ekiwi/iph/measurements/20140710/20MHz_random_data/Readme.md

# 20MHz of random data

## Scope0-6
* Signal Generator Output: 2V
* Modulated Current Source with 47 Ohm resistor to ground and 470 Ohm series
  resistance
* green: input signal
* red: optical output, received with custom board
