ekiwi/iph/presentation/pres01.odp

Optischer Link

## Analoger Link

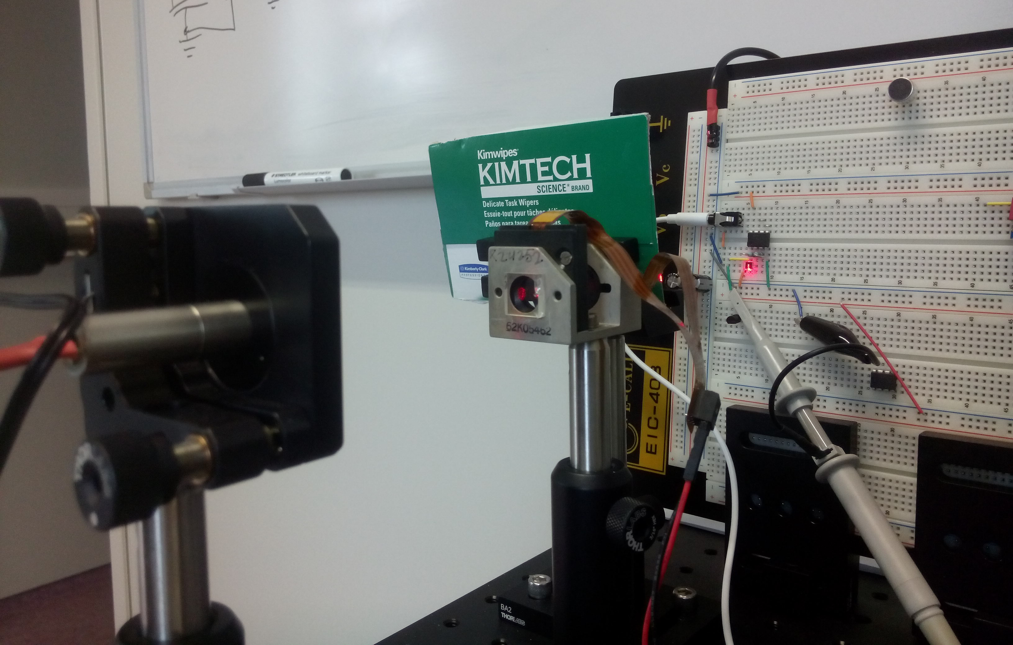
[picture p18: figure]

Ziel:

externe Modulation eines Lasers

mittels LCD-Pixel

## Slide 3

Laser

Signalgenerator

Sinus 0-1000Hz

LCD Pixel

Photodiode

mit Bias

Oszilloskop

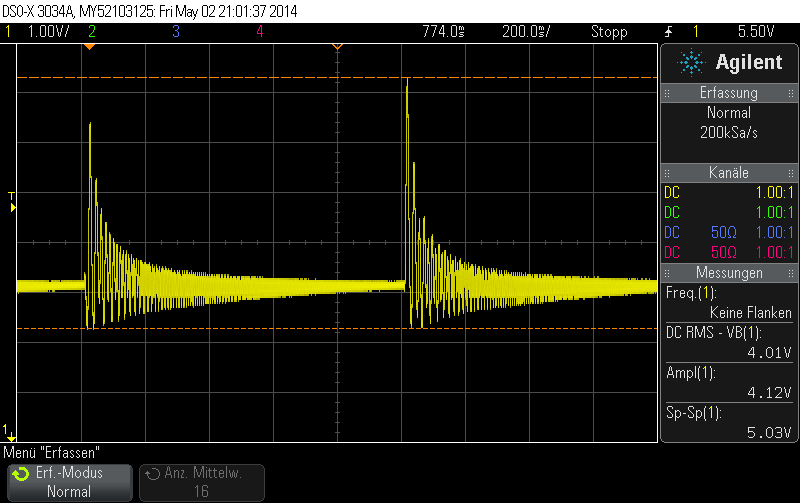
[picture p19: figure]

## Slide 4

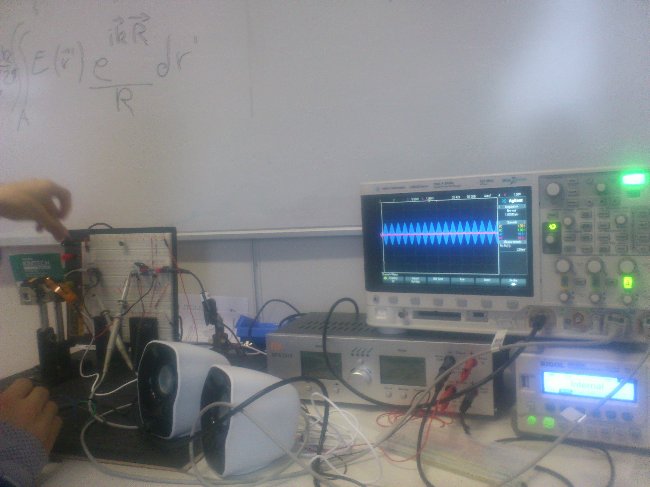
[picture p20: figure]

## Slide 5

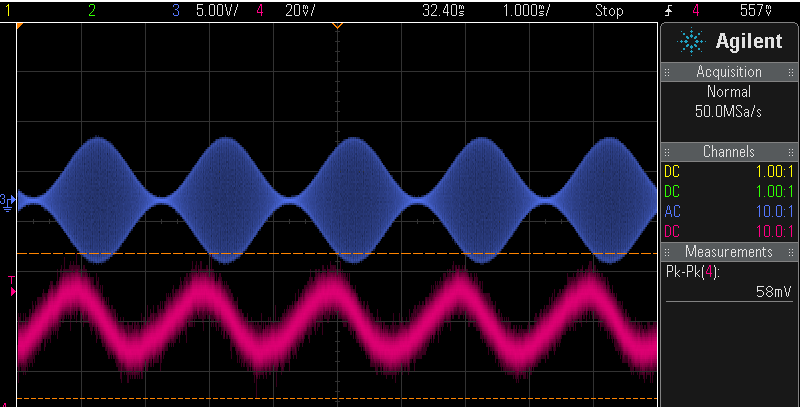
[picture p21: figure]

## Slide 6

Raphael

## UART

## Slide 8

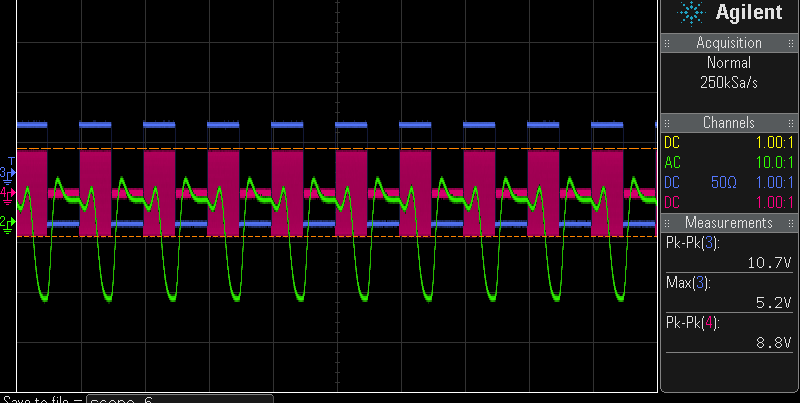
[picture p22: figure]
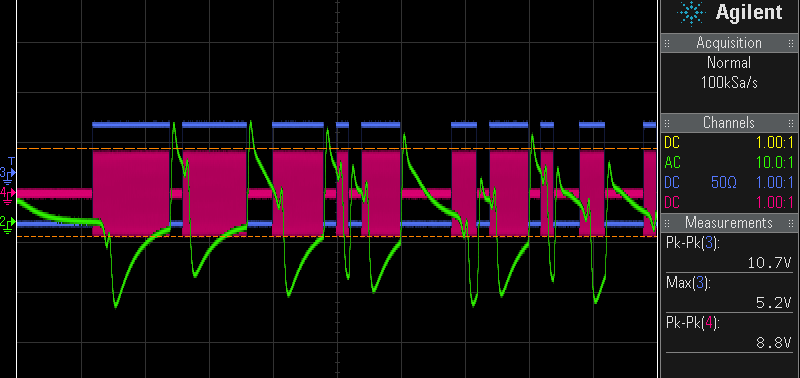
[picture p23: figure]

10 Hz

toggle

10 Hz

zufällig

## 4 Hz Software UART

Kevin

## Digitaler Link

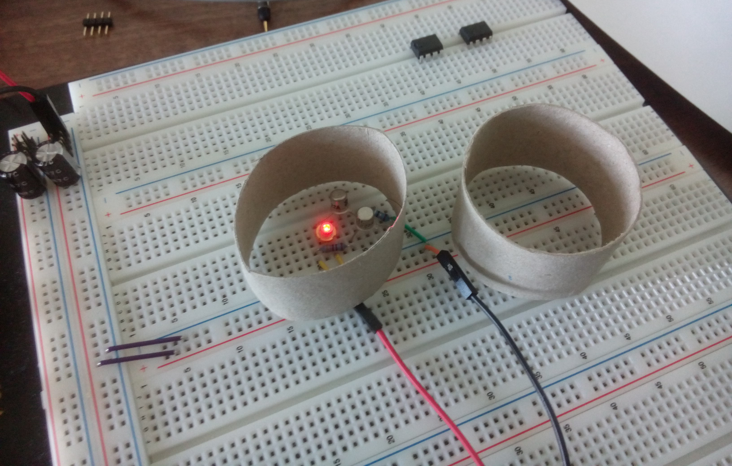
[picture p24: figure]

Ziel:

Direkte Modulation einer Laserdiode

## Direkt modulierbare Stromquelle

- Kevin

## Augendiagramme und weiter Bilder

- Raphael
