ekiwi/iph/report.pdf

Institut fur integrierte Photonik ¨

der

RWTH Aachen University

Institutsprojekt

# Optischer Link

### Teilnehmer: Raphael Brandis Kevin Laufer ¨

### Betreuer: Johannes Hauck

### 31. August 2014

## Inhaltsverzeichnis

1 Aufgabenstellung | 2
2 Extern modulierter Laser | 2
2.1.1 | Ubertragungscharakteristik | ¨ | 3
2.2 Ubertragung von Audiosignalen | ¨ | | 4
2.3 Ubertragung digitaler Daten | ¨ | | 6
2.3.2 | Datenubertragung mit 10 Hz | ¨ | 7
3 Direkt modulierter Laser | 12

3.3 Empfänger mit integriertem AD8015 Transimpedanzverstärker 16

4 Fazit | 20
A C++-Quellcode-Ausschnitte | 21

1

## 1 Aufgabenstellung

Wir sind Studenten der Elektrotechnik an der RWTH Aachen und haben unser Viertsemester-Institutsprojekt am Institut fur Integrierte Photonik (IPH) ¨ absolviert. Im Rahmen dieses Projekts haben wir uns mit der Ubertragung ¨
von Informationen uber optische Links besch ¨ | äftigt.
Im ersten von zwei Projektteilen ging es zunächst um Informationsuber- ¨ mittlung mittels eines extern modulierten Laserstrahls. Anschließend sollte im zweiten Abschnitt des Projekts eine Laserdiode direkt moduliert und auf diese Weise digitale Daten ubertragen werden. ¨

## 2 Extern modulierter Laser

Um mit einem mit konstanter Intensität strahlenden Laser Informationen zu ubertragen, muss mindestens ein Parameter des Laserstrahls extern modu- ¨ liert werden. Mögliche Modulationsparameter sind beispielsweise die Amplitude oder die Phase des Laserstrahls. In unseren Versuchen kam ausschließlich Amplitudenmodulation zum Einsatz.
Wenn die Amplitude eines Laserstrahls extern moduliert werden soll, sind wiederum verschiedene Aufbauten als Modulator denkbar. Ein Lautsprecher mit einem in der Mitte der Membran angebrachten kleinen Spiegel kann je nach Auslenkung der Membran die Intensität des auf der Photodiode des Empfängers auftreffenden Lichts verändern; mit dieser Technik hat sich eine zweite Projektgruppe genauer beschäftigt. Wir haben uns stattdessen fur die ¨ Variante entschieden, bei der ein einzelner LCD-Pixel¹
| zum Einsatz kommt.

### 2.1 LCD-Modul als Modulator

Ein einzelner Pixel eines LCD besteht ublicherweise aus einer Fl ¨ | ussigkristall- ¨
schicht, an die uber zwei Elektroden ein elektrisches Feld angelegt werden ¨ kann, sowie einem horizontalen und einem vertikalen Polarisationsfilter, je einer vor und einer hinter der Kristallschicht.
Wären die Flussigkristalle nicht vorhanden, w ¨ | urden beide Polarisations- ¨
filter zusammen das gesamte einfallende Licht herausfiltern. Die zusätzliche Kristallschicht zwischen beiden Filtern sorgt jedoch fur eine Drehung der ¨ Polarisation des durch den ersten Filter polarisierten Lichts. Da sich die
Ausrichtung der Kristalle uber das angelegte Feld beziehungsweise ¨ | uber die ¨
angelegte Spannung steuern lässt, lässt sich somit auch die Menge des insgesamt durchgelassenen Lichts steuern.

1
engl. liquid crystal display

2

Da in unseren Versuchsaufbauten eine Laserdiode als Lichtquelle diente, war das in den Modulator einfallende Licht bereits polarisiert. Der von uns verwendete LCD-Pixel musste daher nur uber einen Polarisationsfilter hinter ¨ der Kristallschicht verfugen. ¨

### 2.1.1 Ubertragungscharakteristik ¨

Um das Ubertragungsverhalten des verwendeten LCD-Modulators zu ermit- ¨ teln, haben wir zunächst einen sehr einfachen Versuchsaufbau verwendet: Der Modulator wurde direkt an einen Rigol DG1022 -Signalgenerator angeschlossen, als Empfänger diente eine kommerziell erhältliche Photodiode mit integrierter Biasspannung. Mit dem Oszilloskop konnten wir nun die Amplitude des empfangenen Signals bei Ubertragung von Sinusschwingungen ¨

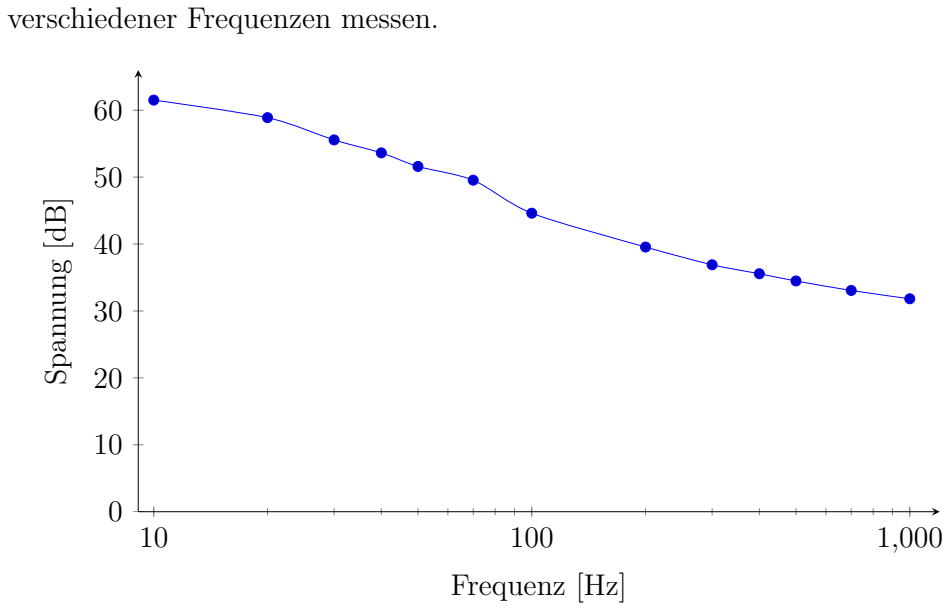
[picture p25: figure]
verschiedener Frequenzen messen.; Frequenz [Hz]; Spannung [dB]

Abbildung 1: Ubertragungscharakteristik des LCD-Modulators (Tr ¨ | ägerfre-
quenz: 100 kHz, Amplitude: ±6 V)

In unseren Messungen fiel die Amplitude schon im niedrigen zweistelligen Frequenzbereich stark ab. Bei einer von 10 Hz ausgehenden Messreihe war der −3 dB-Punkt bereits bei cirka 20 Hz erreicht. Durch Verwendung einer hochfrequenten Trägerwelle, die mit dem niederfrequenten Nutzsignal amplitudenmoduliert wurde²

, ließ sich das Ubertragungsverhalten geringf ¨ | ugig ¨
verbessern (siehe Abbildung 2). Insgesamt mussten wir dennoch feststellen,

2 Diese Funktion stellte der verwendete Signalgenerator von Haus aus bereit.

3

dass sich der von uns verwendete LCD-Pixel aufgrund seiner geringen Geschwindigkeit nur eingeschränkt als Modulator zur Informationsubertragung ¨ eignet (siehe Frequenzgang in Abbildung 1).

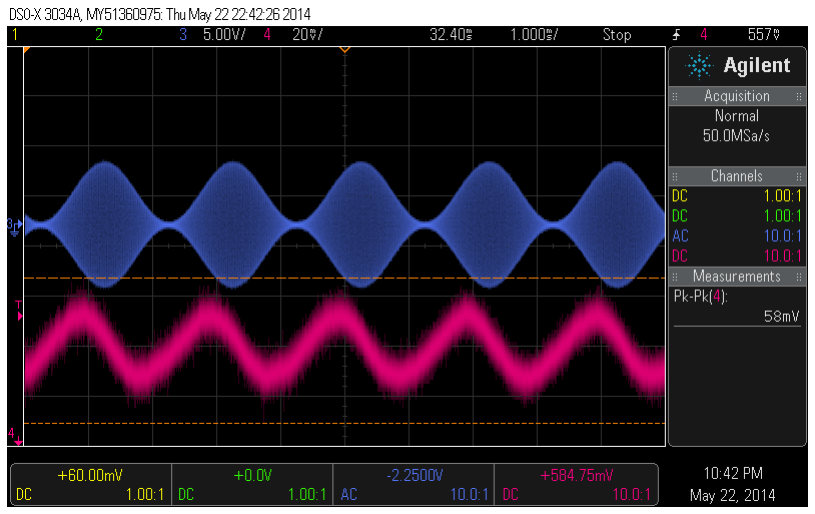
[picture p26: figure]

Abbildung 2: Blau: AM-modulierte Trägerwelle, Rosa: Empfangenes Signal

### 2.2 Ubertragung von Audiosignalen ¨

Im nächsten Schritt sollten statt einfachen Sinussignalen, die sich direkt im Signalgenerator erzeugen lassen, komplexere Audiosignale mithilfe unseres analogen Links ubertragen werden — beispielsweise Musik. ¨
Aufgrund der in Abschnitt 2.1.1 erläuterten Versuchsergebnisse war es unser Ziel, den Modulator weiterhin mit einer hochfrequenten, amplitudenmodulierten Trägerwelle anzusteuern. Da der Modulationseingang des Signalgenerators nach einem Pegel von ±5 V verlangte, haben wir zunächst auf dem Breadboard eine diskrete Kopfhörerverstärkerschaltung aufgebaut, die das aus einem Smartphone oder einem Computer kommende Musiksignal auf den nötigen Pegel verstärkt.
Auf der Empfängerseite kam eine ebenfalls diskret aufgebaute Transimpedanzverstärkerschaltung zum Einsatz, an die zwei aktive Lautsprecher angeschlossen wurden. Der Aufbau aus Laserdiode, LCD-Modulator und Photodiode mit Transimpedanzverstärker ist in Abbildung 3 zu sehen.

4


Abbildung 3: Versuchsaufbau zur Ubertragung von Audiosignalen ¨

War bei der Ubertragung einzelner Sinust ¨ | öne der Ton noch bis in hohe Fre-
quenzbereiche (>10 kHz) hörbar, so verschlechterte sich das Ubertragungs- ¨ verhalten fur breitbandige Musiksignale sehr stark. Erst durch eine Band- ¨ breitenbegrenzung der Musik auf Frequenzen bis maximal 750 Hz wurden einzelne Basstöne aus dem Ursprungssignal erkennbar, die jedoch weiterhin von starken Störgeräuschen und Verzerrungen begleitet wurden.

5

(a) Bandbreitenbegrenztes Ursprungssignal
(b) Mit einem Mikrofon aufgezeichnete Ausgabe der Lautsprecher

Abbildung 4: Ubertragung eines Musiksignals ¨

In Abbildung 4 ist die geringe Ubereinstimmung der Wellenformen des zu ¨
ubertragenden Musiksignals (4a) und des aus den Lautsprechern zu h ¨ | örenden
Signals (4b) zu erkennen.
Auch bei reinen Sprachsignalen reichte die Ubertragungsqualit ¨ | ät bei wei-
tem nicht aus, um Sprachverständlichkeit zu gewährleisten.

### 2.3 Ubertragung digitaler Daten ¨

Nach den Experimenten mit der analogen Signalubertragung war es von In- ¨ teresse, auch einmal digitale Daten uber den bestehenden optischen Link zu ¨ ubertragen. ¨

### 2.3.1 USB-UART-Dongle

In einem ersten Ansatz wurden gunstige UART ¨

3
| -USB-Adapter verwendet.
Die Adapter arbeiten mit 3.3 V-CMOS-Signalen, die mittels eines Komparators auf den nötigen Pegel von ±5 V gebracht werden. Mit diesem Pegel lässt sich der Eingang des Rigol DG1022 -Signalgenerators ansteuern. Bei Amplitudenmodulation fuhren dann +5 V zur maximalen Amplitude und -5 V ¨ zu einer Amplitude von fast Null. So ließ sich ein einfaches On-Off-Keying umsetzen.

3 Universal Asynchronous Receiver / Transmitter

6

Leider war es nicht möglich, bei den verwendeten UART-Adaptern Baudraten unter 1 kHz einzustellen. Dies war aber deutlich zu schnell fur das LCD, ¨ wie man in Abbildung 5 sehen kann. Hier wurde am Computer eine Taste im Terminal gedruckt gehalten, um immer den gleichen Wert zu senden. ¨
Man beachte, dass bei dieser und allen folgenden Messungen der grune ¨ Kanal, also die Messung am Ausgang des Transimpedanzverstärkers, auf AC Coupling eingestellt war. Somit sind die Messergebnisse nicht verlässlich und es lassen sich höchstens Tendenzen feststellen. Hier wäre es interessant, die Messungen noch einmal mit richtigen Einstellungen zu wiederholen. Dennoch ist klar erkennbar, dass ein kurzes High am Ausgang des UART-Adapters (blauer Kanal) zu wenig Anderung am Ausgang des Transimpe- ¨ danzverstärkers fuhrt. Das LCD kann dem Signal vermutlich nicht schnell ¨ genug folgen.

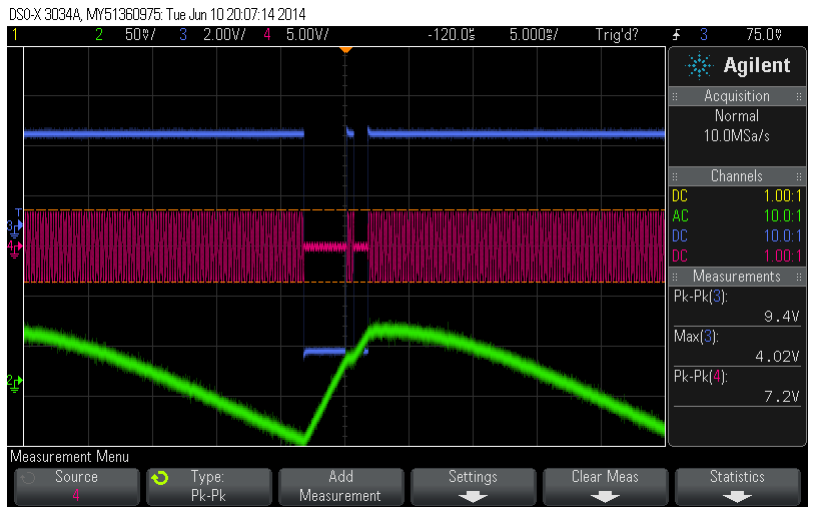
[picture p27: figure]

Abbildung 5: Hier wird kontinuierlich der gleiche Wert mittels UART gesendet.

### 2.3.2 Datenubertragung mit 10 Hz ¨

Nachdem die UART-Adapter nicht langsam genug Daten liefern konnten, wurde als nächstes ein weiterer Signalgenerator verwendet, der in der Lage war, Bitsequenzen mit einer bestimmten Frequenz zu erzeugen, in unserem Fall mit 10 Hz. Diese Bitsequenzen wurden genutzt, um mittels On-Off-Keying das LCD anzusteuern.
Interessant ist hierbei der Unterschied zwischen einem determinierten Muster aus sich abwechselnden Nullen und Einsen und einem Zufallsmuster. Wie in Abbildung 6 gut zu sehen ist, kann sich das LCD auf eine konstante

7

Frequenz einschwingen. Bei einem Zufallssignal hingegen hängt das Signal von der Vorgeschichte ab. Hier wird deutlich, warum bei Messungen der Signalqualität (z.B. bei der Erstellung von Augendiagrammen, siehe 3.4) ein Zufallssignal verwendet werden sollte und ein deterministisches Signal nicht ausreicht.

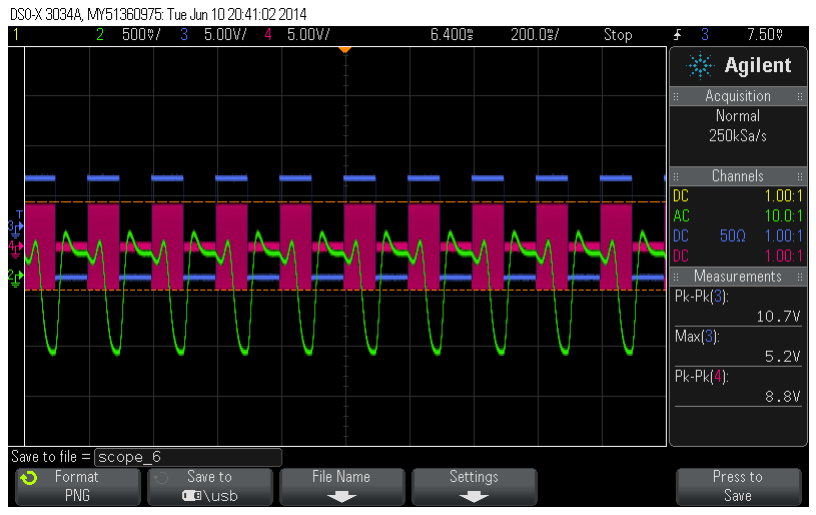
[picture p28: figure]

(a) Abwechselnde Nullen und Einsen

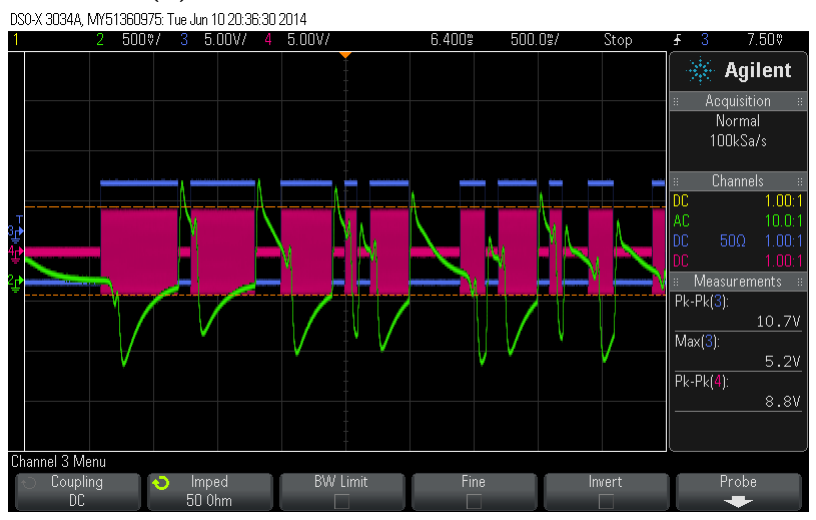
[picture p29: figure]

(b) Zufälliges Signal

Abbildung 6: Ubertragung verschiedener 10 Hz-Signale ¨

### 2.3.3 Software-UART mit Mikrocontrollern

Um nun endlich digitale Nutzdaten zu ubertragen, haben wir auf einem ¨ Mikrocontroller UART in Software implementiert, um die verwendete Baudrate beliebig niedrig wählen zu können. Hierzu wurden zwei STMicroelectronics Discovery Boards verwendet, eines mit STM32F4 - und eines mit

8

STM32F3 -Mikrocontroller. Der Quellcode nutzt die XPCC -Bibliothek und ist auf http://github.com/ekiwi/iph abrufbar. Die wichtigsten funktionalen Bestandteile sind aber auch im Anhang A zu finden.
Zur Verbesserung der Robustheit der Ubertragung kam ein (7,4)-Hamming- ¨
Code zum Einsatz, bei dem alle gultigen Codew ¨ | örter untereinander einen
Hammingabstand von mindestens drei besitzen. Somit kommen auf vier Datenbits drei Paritätsbits, was die Korrektur einfacher Bitfehler erlaubt. Ein möglicher Algorithmus hierfur sieht wie folgt aus (siehe auch Quellcode in ¨ Anhang A.1):
Fur ein empfangenes Wort wird der Hammingabstand zu jedem g ¨ | ultigen ¨
Codewort errechnet. Beträgt der Abstand eins oder null, wird davon ausgegangen, dass das empfangene Wort dem Codewort entspricht. Bei zweifachen Bitfehlern fuhrt dies zu einer falschen Zuordnung: Da der Hammingabstand ¨
zwischen zwei gultigen Codeworten drei betr ¨ | ägt und bei zwei Bitfehlern der
Abstand zum ursprunglichen Codewort zwei ist, gibt es ein anderes Code- ¨ wort, zu dem die empfangene Sequenz nur einen Hammingabstand von eins hat. Diesem Codewort wird das empfangene Wort fälschlicherweise zugeord-

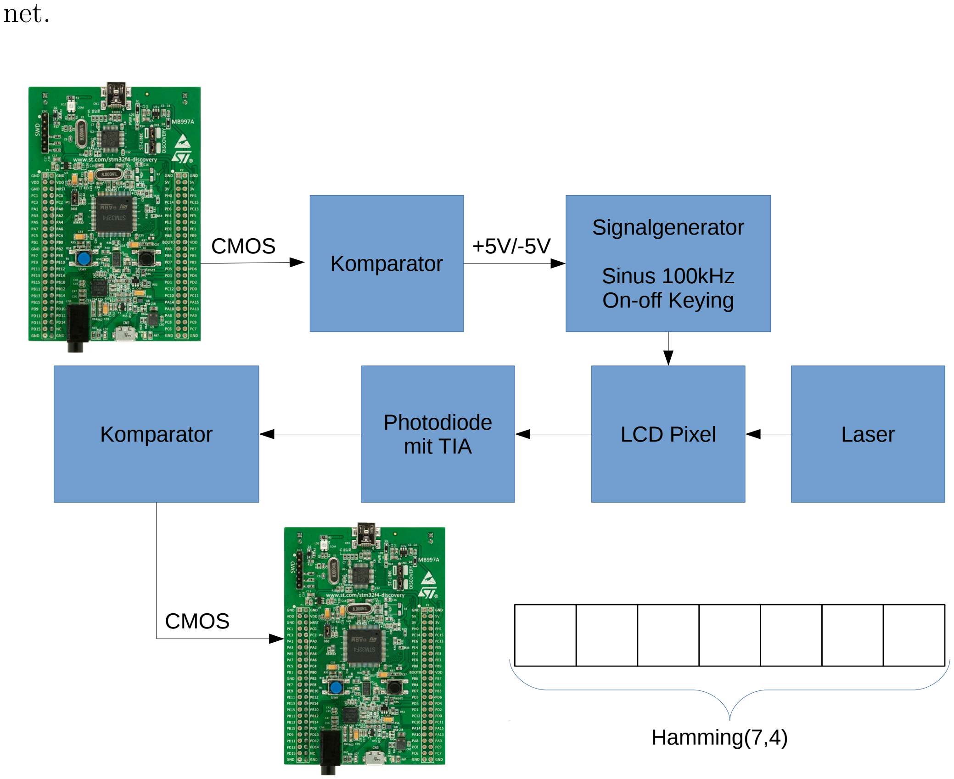
[picture p30: figure]
net.; Signalgenerator; Sinus 100kHz On-off Keying; Komparator; LCD Pixel; Laser; CMOS; Photodiode mit TIA; Hamming(7,4)

Abbildung 7: Software-UART-Signalkette

9

Zum Test der Ubertragung wurden 294 Datenw ¨ | örter in (7,4)-Hamming-
Codierung ubertragen. Der Versuchsaufbau ist in Abbildung 7 dargestellt. ¨ Die Positionierung des Lasers und der Empfängerdiode entsprachen dem in Abbildung 3 gezeigten Aufbau. Der Inhalt der Datenpakete waren die Zahlen von 0 bis 15. Dies reduziert die Aussagekraft des Experiments etwas im Vergleich zu randomisierten Daten, erleichterte aber die Auswertung erheblich. Um nämlich zwei oder mehr Bitfehler erkennen zu können, mussen die ¨ gesendeten Daten am Empfänger bekannt sein. Somit gelangten wir zu der in Abbildung 8 dargestellten Fehlerverteilung.
| 0 Fehler

26%

1 Fehler

62%

2+ Fehler

12%

Abbildung 8: Fehler bei der Ubertragung von 294 (7,4)-Hamming- ¨ codierten, deterministischen Datenworten mit einem 4 Hz-UART-Signal

Demnach sind, nach Fehlerkorrektur durch den Hammingcode, immer noch
12 % der empfangenen Daten falsch und mussten in einem echten ¨ | Ubertra- ¨
gungssystem durch höhere Layer abgefangen werden. Die Rate der Datenbits berechnet sich wie folgt:

4 bit/s ∗

4 bit
7 bit
≈ 2.3 bit/s | (1)
Somit wurden uber etwa 30 cm mit 2 ¨ | .3 bit/s und einer recht hohen Fehler-
rate von 12 % Daten ubertragen — kein sehr gutes Ergebnis. ¨
Doch wie ist dieses schlechte Resultat zu erklären? Fur eine Erkl ¨ | ärungsver-
such lohnt es sich, die Messungen in Abbildung 9 zu betrachten. Hier sieht man, dass eine zufällig ausgewählte steigende Flanke (9a) 162 ms benötigt, um durch das System zu propagieren. Eine fallende Flanke (9b) hat mit 20 ms eine deutlich kleinere Verzögerung. Weitere beobachtete Flanken wiesen Verzögerungen in der gleichen Größenordnung auf.

10


(a) steigende Flanke: 162 ms


(b) fallende Flanke: 20 ms

Abbildung 9: Verzögerung bei einem 4 Hz-UART-Signal; Quellensignal in gelb und invertiertes Ausgangssignal in grun¨

Da bei einem zufälligen Bit eine steigende Flanke sowohl an dessen Anfang als auch an dessen Ende auftreten kann, musste man demnach mehr als ¨ 162 ms nach Anfang und 162 ms vor Ende eines Bits sampeln, um Fehler ganz zu vermeiden. Dies fuhrt zu folgender maximaler Datenrate: ¨

Tmin = 162 ms ∗ 2 = 324 ms | (2)

fmax =

1

Tmin

=

1
324 ms
≈ 3 bit/s | (3)

Ein Absenken der Bitrate auf 3 bit/s in Kombination mit einer intelligenten Wahl des Samplingzeitpunktes könnte also eine Hamming-Codierung uber- ¨
flussig machen und somit zu einer h ¨ | öheren Datenrate fuhren. Hierf ¨ | ur m ¨ | ussen ¨
aber die Latenzen bekannt sein und bei der Synchronisation durch die erste fallende Flanke (siehe Anhang A.3, Zeile 39) berucksichtigt werden. ¨

11

Als wir bei einem Test ohne Kenntnis der Latenz mit einer Datenrate von 2 bit/s Daten ubertragen haben, traten fast keine Bitfehler auf. ¨
Die mit den oben aufgefuhrten Berechnungen ermittelte maximale theoreti- ¨ sche Datenrate von etwa 3 bit/s ist jedoch weiterhin sehr niedrig. Interessant wäre es daher, die Ursache der Latenz zu untersuchen. Hierbei sollte bei verschiedenen Ansteuerungsarten des LCD die erzielte Latenz gemessen werden. Mit den oben genannten Berechnungen lässt sich daraus die mögliche Datenrate berechnen.

## 3 Direkt modulierter Laser

Im zweiten Teil des Projekts sollte ein Diodenlaser direkt moduliert werden, um damit digitale Daten zu ubertragen. Dazu hatte die andere Gruppe ¨ bereits eine Modulationsmethode untersucht, bei der auf einen konstanten Strom ein Datensignal aufgekoppelt wurde.
Unser Ziel war es, eine Stromquelle direkt mit einem Datensignal zu modulieren und danach Empfängerdesigns zu evaluieren.

### 3.1 Sender: Modulierte Konstantstromquelle

Aufgrund der exponentiellen Kennlinie einer Laserdiode muss diese mit einem konstanten Strom versorgt werden. Eine einfache Konstantstromquelle lässt sich mit zwei Bipolartransistoren aufbauen, wie in Abbildung 10 zu sehen ist.

12

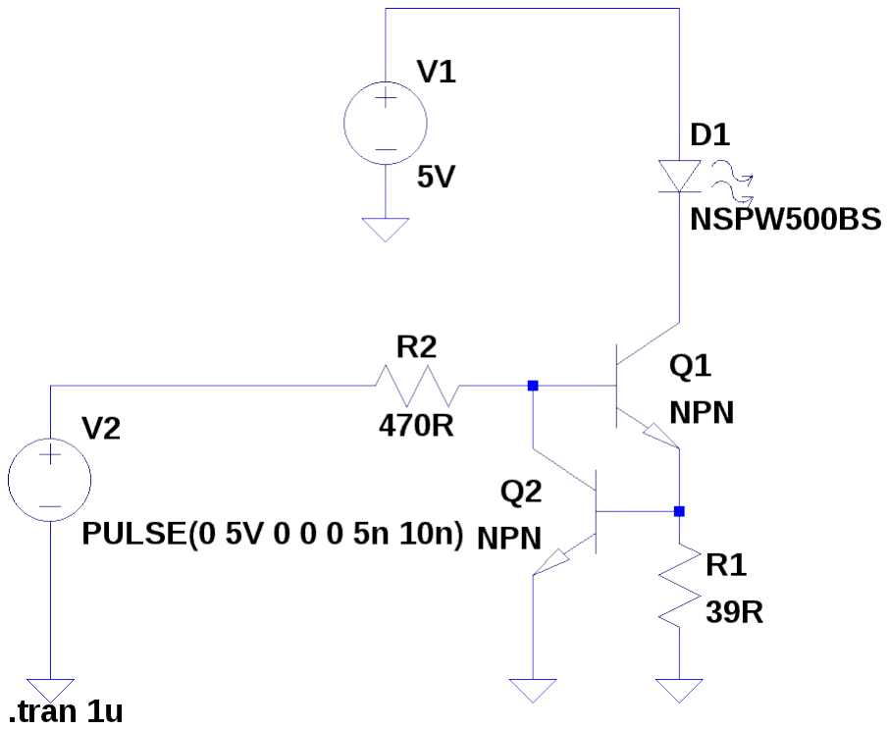
[picture p31: figure]

Abbildung 10: Modulierte Stromquelle.

Der Strom ID1, der durch die Diode fließt, entspricht hierbei in etwa dem Strom IR1, der durch den Widerstand R1 fließt. An diesem mussen, durch ¨ den Transistor Q2 vorgegeben, etwa 0.7 V abfallen, wodurch sich folgender Strom einstellt:

ID1 = IR1 =

UR1
R1

≈

0.7 V
R1

(4)

Diese Konstantstromquelle lässt sich leicht ein- und ausschalten, indem uber einen Widerstand die Summe der Basis-Emitter-Spannungen beider ¨ Transistoren, UBE1 + UBE2, vorgegeben wird.

13

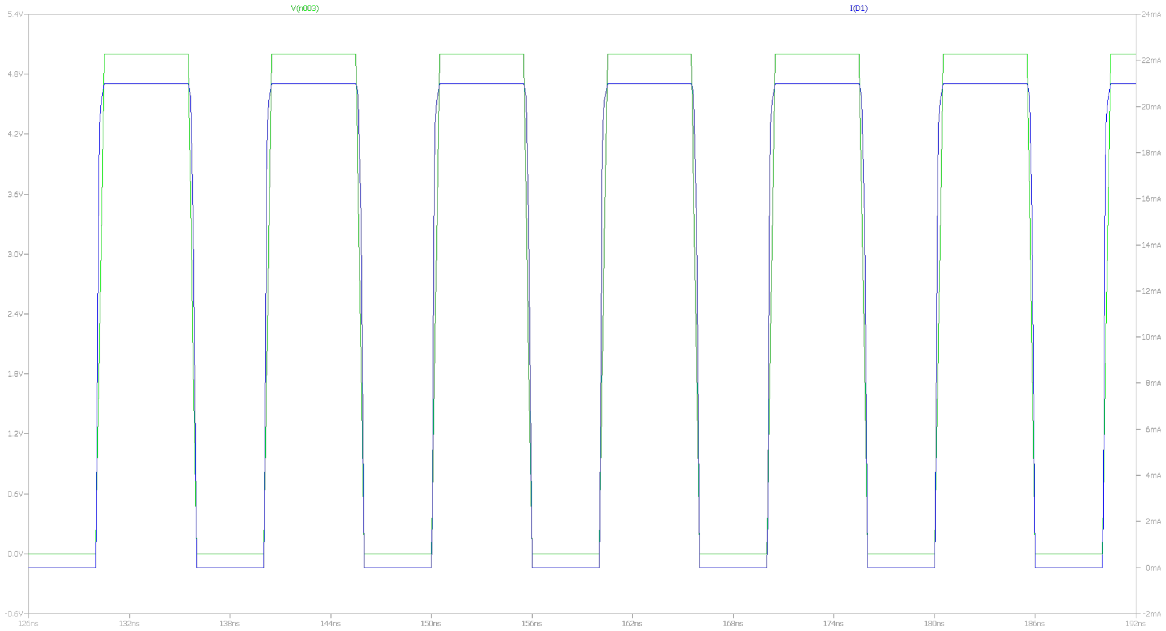
[picture p32: figure]

Abbildung 11: Transientenanalyse der modulierten Stromquelle

Eine Simulation des Aufbaus in LTSpice zeigt, dass der Strom ID1 durch die Diode von der Eingangsspannung U2 abhängt. Bei den in Abbildung 11 dargestellten Ergebnissen wurde zwar mit einem vereinfachten Transistormodell simuliert, sie sind also mit Vorsicht zu genießen. Das Funktionsprinzip wird durch die Simulation dennoch gut veranschaulicht.

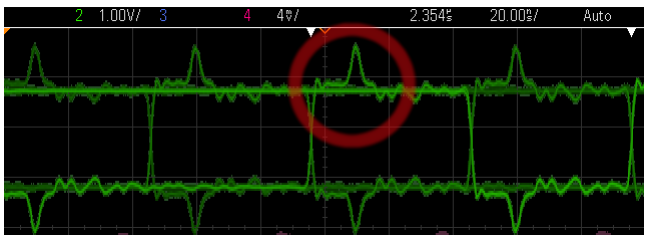
[picture p33: figure]

Abbildung 12: Reflexionen bei einem 20 MHz-Eingangssignal

Mit diesem Aufbau ließen sich in unseren Versuchen recht schnelle Ubert- ¨ ragungen von zufälligen Bits realisieren (siehe auch Abschnitt 3.2). Es gab jedoch aufgrund der fehlenden Terminierung auf der Eingangsseite unserer Schaltung Probleme mit Reflexionen auf der Leitung (siehe Abbildung 12).

14

Hier wäre eine Untersuchung verschiedener Terminierungsvarianten interessant.
Auch verhält sich die Schaltung bei Frequenzen im Megahertzbereich immer weniger wie in der Simulation: So entspricht die Spannung am Widerstand R1 nicht mehr den erwarteten 0.7 V. Hier wären eine Verbesserung der Spice-Simulation durch die Auswahl eines passenden Transistormodells und durch bessere Modellierung der Quelle sowie weitere empirische Versuche angebracht.

### 3.2 Photodiode mit Lastwiderstand als Empfänger

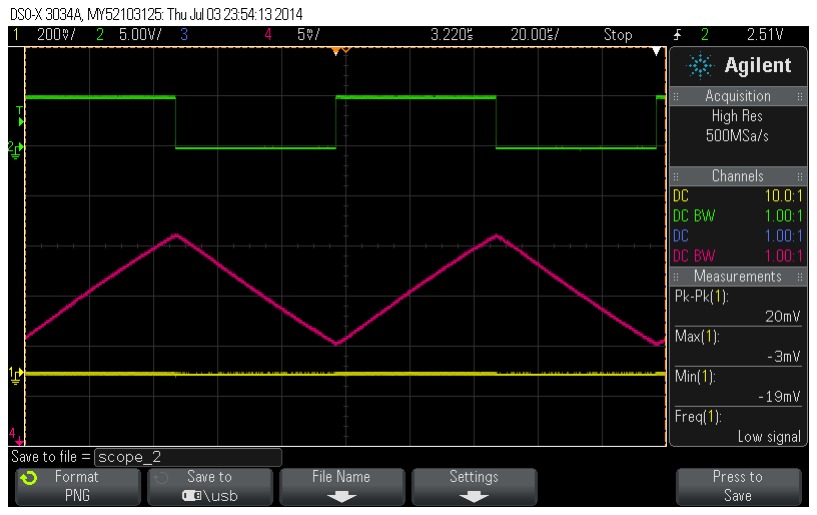
[picture p34: figure]

(a) 10 kΩ


(b) 50 Ω

Abbildung 13: Grun: Gesendetes 20 kHz-Rechtecksignal; Rosa: Empfange- ¨ nes Signal bei unterschiedlichem Lastwiderstand

Zum Testen der Sendeschaltung nutzten wir zunächst eine Photodiode mit Biasspannung und umschaltbarem Lastwiderstand (NewFocus 1623 ) als Empfänger.

15

In Abbildung 13 ist die Abhängigkeit des Ausgangssignals vom Lastwiderstand zu erkennen. Zur Aufnahme dieser Messungen wurde der Ausgang der Photodiode mit einem hochohmig terminierten Eingang eines Oszilloskops verbunden und auf den Eingang unserer Sendeschaltung ein 20 kHz-Rechtecksignal gegeben. Bei einem hohen Lastwiderstand (13a) erhöht sich die Verstärkung: Die Amplitude beträgt hier in etwa 10 mV. Jedoch sinkt die Bandbreite, was sich durch sehr lange Anstiegs- und Abfallzeiten und die daraus resultierende Dreiecksform des Ausgangssignals bemerkbar macht. Mit einem kleineren Lastwiderstand (13b) ergibt sich ein weniger verzerrtes Signal, die Amplitude beträgt jedoch nur noch in etwa 1 mV.
Die kleinen Amplituden und die Verzerrung beim Empfang eines 20 kHz-
Signals weisen darauf hin, dass fur schnellere Signale ein besserer Verst ¨ | ärker
benötigt wird.

### 3.3 Empfänger mit integriertem AD8015 Transimpedanzverstärker

C2

10u

C3

100n

GND

+5V

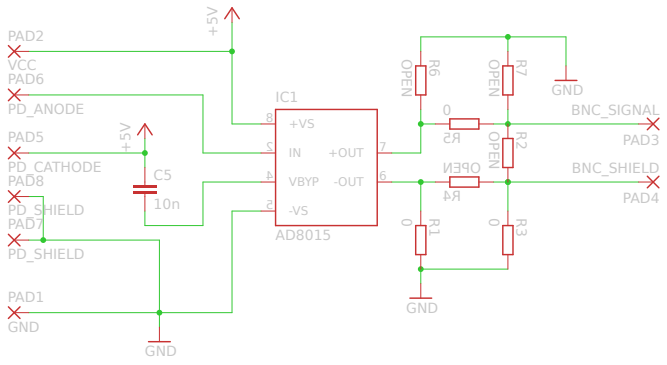
[picture p35: figure]
GND; +OUT; -OUT; VBYP 4; PAD1; PAD2; VCC; PAD3; BNC_SIGNAL; PAD4; BNC_SHIELD; PAD5; PD_CATHODE; PAD6; PD_ANODE; PAD7; PD_SHIELD; PAD8; OPEN

Abbildung 14: Beschaltung des AD8015 -Transimpedanzverstärkers

Anstatt selbst eine Empfängerschaltung aufzubauen, bietet es sich an, einen integrierten Transimpedanzverstärker wie den AD8015 zu verwenden. Dieser ist von Grund auf dafur konzipiert, den Photostrom in eine proportional ¨ verstärkte Spannung zu wandeln, die differentiell mit einer Impedanz von

16

50 Ω am Ausgang abgegriffen werden kann. Es werden nur wenige externe Komponenten benötigt, was zu einer einfachen Schaltung fuhrt (siehe Abbil- ¨ dung 14).
Mit diesem Aufbau lassen sich auch schnelle Signale verstärken, wie in der Betrachtung der Augendiagramme im nächsten Abschnitt deutlich wird.

### 3.4 Augendiagramme

Augendiagramme können mit dem Oszilloskop aufgenommen werden. Hierzu wird der Trigger auf steigende und fallende Flanken des Signals eingestellt und Persistenz aktiviert. Hierdurch erhält man eine Uberlagerung von stei- ¨ genden und fallenden Flanken. Verbleibt zwischen diesen eine klar erkennbare Offnung (das Auge), kann man davon ausgehen, dass die Bits auch von einer ¨ Empfängerschaltung richtig interpretiert werden können.
Wichtig ist, als Eingangssignal eine Zufallssequenz von Bits zu wählen, damit sich das System nicht einfach auf eine Frequenz einschwingt.


Abbildung 15: Versuchsaufbau zur Erstellung der Augendiagramme

17

In unserem Fall wurden die Augendiagramme in Abbildung 16 und Abbildung 17 mit der Sendeschaltung aus Abschnitt 3.1 und der Empfängerschaltung aus Abschnitt 3.3 aufgenommen. Der Aufbau ist in Abbildung 15 zu sehen.

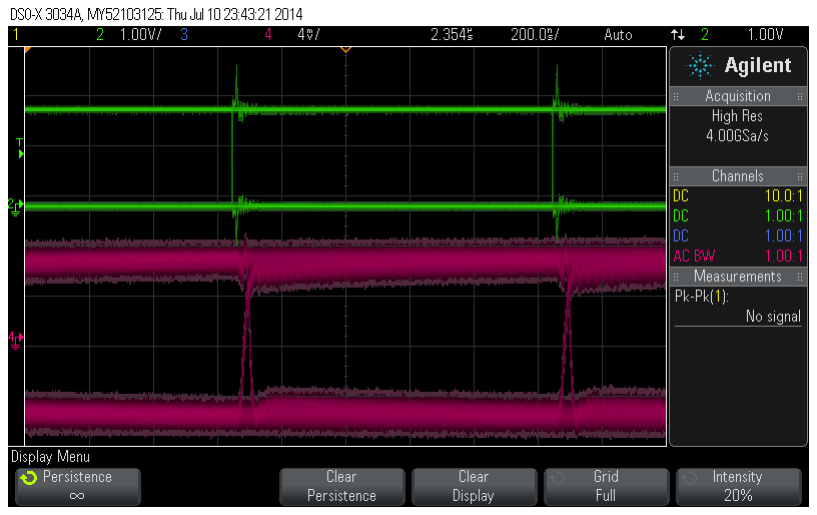
[picture p36: figure]

(a) 1 MHz


(b) 10 MHz

Abbildung 16: Augendiagramme (gesendetes Signal in grun) ¨

18


(a) 30 MHz


(b) 50 MHz

Abbildung 17: Augendiagramme (gesendetes Signal in grun) ¨

Ein 1 MHz-Bitsignal wird ohne Probleme ubertragen (16a), auch bei ei- ¨ nem 10 MHz-Signal ist die Augenöffnung noch unproblematisch (16b). Ein
30 MHz-Signal hat bereits eine deutlich kleinere Offnung (17a), die ¨ | Ubertra- ¨
gung sollte hier aber auch noch funktionieren. Bei 50 MHz scheint die Grenze erreicht; hier ist eine distinkte Offnung kaum noch zu erkennen (17b). ¨

### 3.5 Ergebnisse

Mit dem System aus selbst gebauter modulierbarer Stromquelle und AD8015 -Verstärker lassen sich Signale mit einer Geschwindigkeit von bis zu 50 MHz
gut ubertragen. Die Photodiode ohne Verst ¨ | ärker ist hingegen in diesem Ge-
schwindigkeitsbereich nicht mehr zu gebrauchen.
Bezuglich des Senders sollte man als n ¨ | ächstes versuchen, die verwendete
Schaltung wie in Abschnitt 3.1 beschrieben zu verbessern, um sie dann auf einer Platine aufzubauen. Zusammen mit einem Gehäuse ließe sich damit ein

19

Versuchsaufbau erstellen, mit dem die Schaltung noch besser untersucht und der Laser auch in eine Glasfaser eingekoppelt werden könnte.
Der Empfänger mit AD8015 hat sich bewährt und muss wohl erst einmal nicht verändert werden. Es wäre aber interessant, ihn noch besser zu vermessen. Unter anderem sollte mit einer professionellen Lichtquelle untersucht werden, bis zu welchen Frequenzen verstärkt werden kann. Bisher wurde hier nur das Gesamtsystem aus Empfänger und Sender untersucht, was es erschwert, eindeutige Aussagen uber die Einzelkomponente zu tref- ¨ fen. Interessant könnte es auch sein, die AD8015 -Schaltung mit verschiedenen Photodioden aufzubauen und zu untersuchen, wie sich diese auf das Verstärkungsverhalten auswirken.

## 4 Fazit

Auch wenn wir, insbesondere mit dem LCD, keine besonders großen Erfolge erzielen konnten, so war das Praktikum fur uns dennoch sehr interessant ¨ und lehrreich. Es wurde klar, dass die Beschreibung als LTI-System nur eine
Näherung ist, die sich nicht ohne Weiteres auf das LCD ubertragen l ¨ | ässt.
Es ist daher wichtig, mit Zufallsbitfolgen zu messen, um ein Einschwingen zu verhindern. Auch bedeutet ein einzelner Sinuston, der sich in guter Qua-
lität ubertragen l ¨ | ässt, noch lange nicht, dass man dynamische Musiksignale,
die Frequenzen aus dem gesamten hörbaren Spektrum enthalten, ubertragen ¨ kann.

Im Nachhinein fallen einem zahlreiche Dinge ein, die man hätte besser machen können. So sei Studenten, die in Zukunft dieses Praktikum durchfuhren, ¨ empfohlen, von Anfang an strukturiert vorzugehen. So sollte man sich erst
uberlegen, welche Kenndaten des LCDs ben ¨ | ötigt werden, und anschließend,
wie diese zu messen sind. Sehr wichtig ist außerdem, immer daran zu denken, den Versuchsaufbau zu einer Messung genau zu dokumentieren, um Wiederholbarkeit sicherzustellen. So haben wir es leider versäumt, den genauen Aufbau bei Aufnahme der ersten Messungen mit dem LCD festzuhalten.
Daruber hinaus w ¨ | äre interessant gewesen, einige Messreihen mit unter-
schiedlichen Arten der Ansteuerung des LCDs aufzunehmen. Hier wären Latenz (also Gruppenlaufzeit) und Amplitudenubertragungsfunktion inter- ¨ essant. Unter anderem könnte man den LCD mit verschiedenen Amplituden sowie mit oder ohne hochfrequenter Trägerwelle ansteuern.
Interessant war auch der praktische Einsatz von Kenntnissen aus Grundgebiete der Informatik II bei der Ubertragung von Daten mittels eines Hamming- ¨ Codes. Hier zeigte sich, dass eine niedrigere Ubertragungsgeschwindigkeit ef- ¨

20 fizienter sein kann, da weniger Fehler erzeugt und somit weniger Paritätsbits
benötigt werden. Fur die ¨ | Ubertragung von digitalen Daten w ¨ | äre es bei einer
erneuten Durchfuhrung des Praktikums interessant, nach Charakterisierung ¨ des LCDs eine Ubertragungsstrecke mit niedrigerer Latenz zu konstruieren. ¨ Bei der direkten Modulation des Lasers empfiehlt es sich, die Schaltung des Senders wie oben beschrieben zu optimieren und dann fest aufzubauen, um
Messungen einfacher und genauer durchfuhren zu k ¨ | önnen. Beim Empfänger
mit AD8015 -Verstärker könnte man Messungen mit einer modulierten Lichtquelle, deren Bandbreite bekannt ist, durchfuhren, um seine maximale Band- ¨ breite zu ermitteln.

Gelohnt hat sich definitiv auch, in der Exkursionswoche fur zwei ganze Tage ¨ am Projekt zu arbeiten. So kann man einmal etwas mehr am Stuck erle- ¨ digen, ohne sich Woche fur Woche erneut in das Projekt hineindenken zu ¨
mussen. Wir raten aber davon ab, dass Praktikum komplett an einem St ¨ | uck ¨
durchzufuhren, da dann nicht genug Zeit bleibt, um Teile zu bestellen oder ¨ Platinen fertigen zu lassen.

Zu guter Letzt möchten wir den zukunftigen Teilnehmern dieses Praktikums ¨
viel Erfolg wunschen. Ihr k ¨ | önnt euch auf jeden Fall auf die Unterstutzung ¨
des Instituts verlassen. Egal ob ihr Fragen habt, Hilfe oder Teile fur die ¨ Durchfuhrung braucht, wendet euch einfach an euren Betreuer. ¨
Wir hoffen, dass wir euch mit unserem Projektbericht helfen konnten und wurden uns freuen, in einem Jahr eure Ergebnisse zu sehen. ¨

Viel Spaß!

## A C++-Quellcode-Ausschnitte

### A.1 Hamming-Code

hamming.hpp
1 | #ifndef HAMMING_HPP
2 | #define HAMMING_HPP

3
4 #include <xpcc/debug/logger.hpp>

5
6 | #undef | XPCC_LOG_LEVEL
7 | #define | XPCC_LOG_LEVEL xpcc::log::INFO

8
9 namespace Hamming

21

10 {

11
12 | static constexpr uint8_t
13 | hammingLut[16] = {
14 | 0b00000000, | // 0
15 | 0b00001011, | // 1
16 | 0b00010110, | // 2
17 | 0b00011101, | // 3
18 | 0b00100111, | // 4
19 | 0b00101100, | // 5
20 | 0b00110001, | // 6
21 | 0b00111010, | // 7
22 | 0b01000101, | // 8
23 | 0b01001110, | // 9
24 | 0b01010011, | // 10
25 | 0b01011000, | // 11
26 | 0b01100010, | // 12
27 | 0b01101001, | // 13
28 | 0b01110100, | // 14
29 | 0b01111111, | // 15
30 | };

31
32 | // encodes least significant 4 bits
33 | static uint8_t
34 | encode(uint8_t data) {
35 | return(hammingLut[data & 0xf]);
36 | }

37
38 | static int
39 | decode(uint8_t data) {
40 | int cur_distance, min_distance = 8;
41 | uint8_t data_copy, hamming_word;
42 | int index = 0;

43
44 | for(int ii = 0; ii < 16; ++ii) {
45 | cur_distance = 0;
46 | data_copy = data;
47 | hamming_word = hammingLut[ii];
48 | for(int jj = 0; jj < 8; ++jj) {
49 | | cur_distance += (static_cast<bool>(data_copy & 0x1) !=
50 | | static_cast<bool>(hamming_word & 0x1));

22 data_copy = data_copy >> 1; hamming_word = hamming_word >> 1;

}

if(cur_distance < min_distance) { min_distance = cur_distance; index = ii;

}

}
XPCC_LOG_INFO << min_distance << "," << xpcc::endl; XPCC_LOG_DEBUG << "Minimum Hamming distance: " << min_distance << xpcc::endl;
return index;

}

}

#endif // HAMMING_HPP

https://github.com/ekiwi/iph/blob/master/stm32/lcd_transmitter/hamming. hpp (https://github.com/ekiwi/iph/blob/master/stm32/lcd_transmitter/hamming.hpp)

### A.2 Software-UART: Quelle transmitter.cpp

#include "transmitter.hpp"

#include "../settings.hpp"

#include "../hamming.hpp"

#include <xpcc/architecture/platform.hpp> #include <xpcc/debug/logger.hpp>

using namespace xpcc::stm32;

typedef GpioOutputA5 SendPin;

Transmitter::Transmitter()
: delay(0)

{

23

16 | this->stop();
17 | }

18
19 | void
20 | Transmitter::initialize()
21 | {
22 | SendPin::setOutput(xpcc::Gpio::High);
23 | }

24

25
26 | bool
27 | Transmitter::run()
28 | {
29 | static bool bit;
30 | static int ii;

31
32 | PT_BEGIN();

33
34 | delay.restart(Settings::BitPeriod);

35
36 | // send startbit
37 | SendPin::reset();
38 | PT_WAIT_UNTIL(delay.isExpired());

39
40 | // send 7 databits
41 | ii = 0;
42 | while(ii < 7) {
43 | ++ii;

44
45 | bit = static_cast<bool>(data & (1<<6));
46 | // Send single bit
47 | SendPin::set(bit);
48 | if(bit) XPCC_LOG_DEBUG << "1";
49 | else XPCC_LOG_DEBUG << "0";

50
51 | PT_WAIT_UNTIL(delay.isExpired());

52
53 | data = data << 1;
54 | }

55
56 | // send stopbit
| 24

57 | SendPin::set();
58 | PT_WAIT_UNTIL(delay.isExpired());

59
60 | delay.restart(0); | // stop delay
61 | PT_END();
62 | }

63

64
65 | void
66 | Transmitter::send(uint8_t data) {
67 | if(this->isRunning()) {
68 | XPCC_LOG_ERROR << "Cannot send Data. Not finished!" << xpcc::endl;
69 | return;
70 | }

71
72 | XPCC_LOG_DEBUG << xpcc::endl << "Send: " << data << xpcc::endl;
73 | this->data = | Hamming::encode(data);
74 | this->restart();
75 | }

https://github.com/ekiwi/iph/blob/master/stm32/lcd_transmitter/source/transmitter.cpp (https://github.com/ekiwi/iph/blob/master/stm32/lcd_transmitter/source/transmitter.cpp)

### A.3 Software-UART: Empfänger

receiver.cpp
1 | #include "receiver.hpp"
2 | #include "../settings.hpp"
3 | #include "../hamming.hpp"

4
5 | #include <xpcc/architecture/platform.hpp>
6 | #include <xpcc/debug/logger.hpp>

7
8 using namespace xpcc::stm32;

9
10 | typedef xpcc::GpioInverted<GpioInputA5> ReceivePin;
11 | typedef GpioOutputA7 SampleIndicator;

12

13
14 | #undef | XPCC_LOG_LEVEL
15 | #define | XPCC_LOG_LEVEL xpcc::log::INFO

25

16
17 | Receiver::Receiver()
18 | : delay(0)
19 | {
20 | this->stop();
21 | }

22
23 | void
24 | Receiver::initialize()
25 | {
26 | ReceivePin::setInput();
27 | SampleIndicator::setOutput(xpcc::Gpio::High);
28 | }

29

30
31 | bool
32 | Receiver::run()
33 | {
34 | static bool bit;
35 | static int ii;

36
37 | PT_BEGIN();

38
39 | // wait for falling edge
40 | PT_WAIT_UNTIL(ReceivePin::read());
41 | PT_WAIT_UNTIL(!ReceivePin::read());
42 | XPCC_LOG_DEBUG << "[";

43
44 | // wait for startbit + 1.bit to get transmitted
45 | delay.restart(Settings::ReceiveStartDelay);
46 | PT_WAIT_UNTIL(delay.isExpired());

47
48 | // receive bits
49 | ii = 0;
50 | while(ii < 7) {
51 | ++ii;

52
53 | bit = ReceivePin::read();
54 | SampleIndicator::toggle();
55 | if(bit) XPCC_LOG_DEBUG << "1";
56 | else XPCC_LOG_DEBUG << "0";
| 26

57 | data = (data << 1) | (bit? 1 : 0);

58
59 | delay.restart(Settings::BitPeriod);
60 | PT_WAIT_UNTIL(delay.isExpired());
61 | }

62
63 | // sample stopbit
64 | bit = ReceivePin::read();
65 | SampleIndicator::toggle();
66 | if(bit) {
67 | XPCC_LOG_DEBUG << "]";
68 | } else {
69 | XPCC_LOG_DEBUG << "*E*";
70 | }

71
72 | // done
73 | PT_END();
74 | }

75

76

77

78
79 | void
80 | Receiver::startReceive() {
81 | if(this->isRunning()) {
82 | XPCC_LOG_ERROR << "Cannot receive Data. Not finished!" << xpcc::endl;
83 | return;
84 | }

85
86 | XPCC_LOG_DEBUG << xpcc::endl << "Start receiving"<< xpcc::endl;
87 | this->data = 0;
88 | this->restart();
89 | }

90
91 | uint8_t
92 | Receiver::getResult() {
93 | if(this->isRunning()) {
94 | XPCC_LOG_ERROR << "No result. Not finished!" << xpcc::endl;
95 | return 0;
96 | }

97

| 27

98 | return Hamming::decode(data);
99 | }
| https://github.com/ekiwi/iph/blob/master/stm32/lcd_transmitter/sink/
| receiver.cpp (https://github.com/ekiwi/iph/blob/master/stm32/lcd_transmitter/sink/receiver.cpp)

28
