ekiwi/iph/measurements/20140611/4Hz_overview/scope_1.csv

x-axis | 1 | 2 | 3 | 4
second | Volt | Volt | Volt | Volt
+11.620000E+00 | -21.231E-03 | +3.802764E+00 | +2.840955E+00 | -451.935E-03
+11.622500E+00 | -46.357E-03 | +3.827889E+00 | +2.956533E+00 | +226.457E-03
+11.625000E+00 | -51.382E-03 | +3.827889E+00 | +2.881156E+00 | -451.935E-03
+11.627500E+00 | -86.558E-03 | +3.626884E+00 | +2.906282E+00 | -49.925E-03
+11.630000E+00 | -76.508E-03 | +3.664573E+00 | +2.921357E+00 | -288.618E-03
+11.632500E+00 | -46.357E-03 | +3.752513E+00 | +2.861055E+00 | +264.146E-03
+11.635000E+00 | -76.508E-03 | +3.827889E+00 | +2.936432E+00 | -389.121E-03
+11.637500E+00 | -71.483E-03 | +3.652010E+00 | +2.906282E+00 | +125.955E-03
+11.640000E+00 | -76.508E-03 | +3.802764E+00 | +2.840955E+00 | -112.739E-03
+11.642500E+00 | -76.508E-03 | +3.827889E+00 | +2.876131E+00 | +25.452E-03
+11.645000E+00 | -131.784E-03 | +3.827889E+00 | +2.961558E+00 | -250.930E-03
+11.647500E+00 | +3.894E-03 | +3.827889E+00 | +2.906282E+00 | +151.080E-03
+11.650000E+00 | -136.809E-03 | +3.827889E+00 | +2.906282E+00 | -250.930E-03
+11.652500E+00 | -76.508E-03 | +3.827889E+00 | +2.906282E+00 | +151.080E-03
+11.655000E+00 | -76.508E-03 | +3.765075E+00 | +2.856030E+00 | -250.930E-03
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
