ekiwi/iph/audacity.png

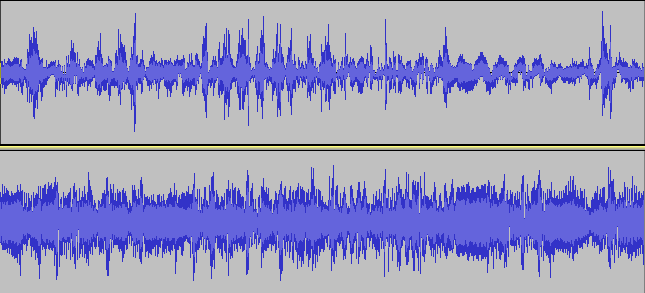
audacity.png
