ekiwi/iph/measurements/20140611/4Hz_overview/scope_0.png

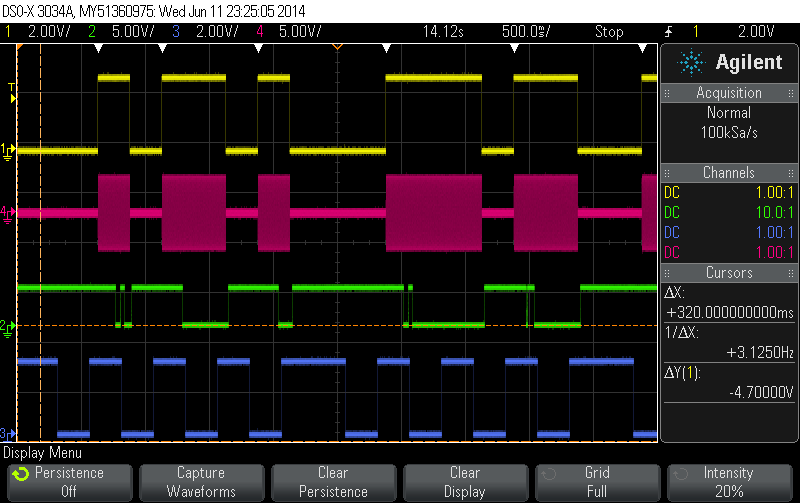
measurements/20140611/4Hz_overview/scope_0.png
