ekiwi/iph/photos/DSC_0660.jpg

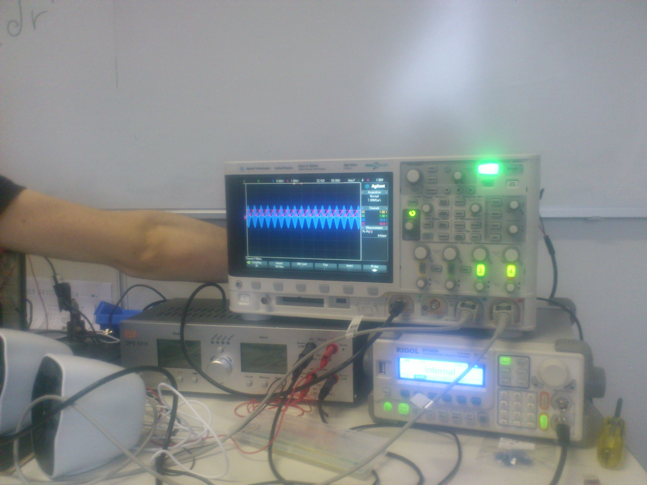
photos/DSC_0660.jpg
