ekiwi/iph/photos/DSC_0662.jpg

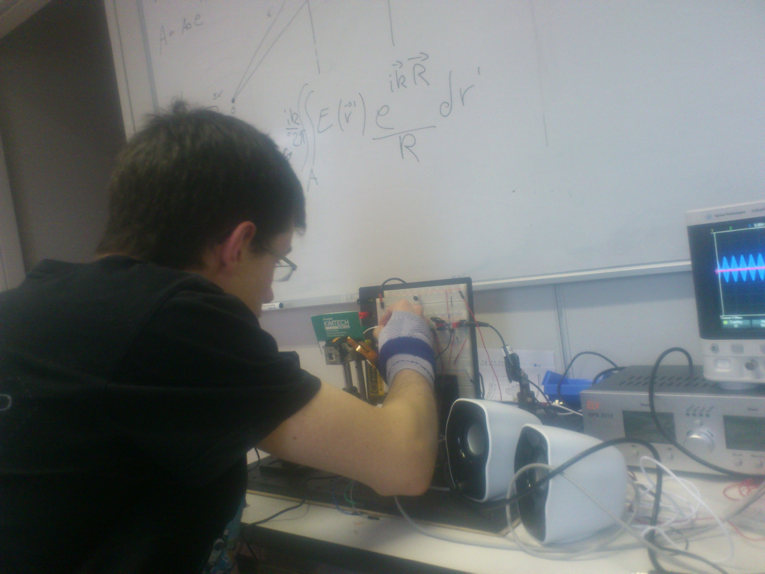
photos/DSC_0662.jpg
