ekiwi/iph/photos/DSC_0663.jpg

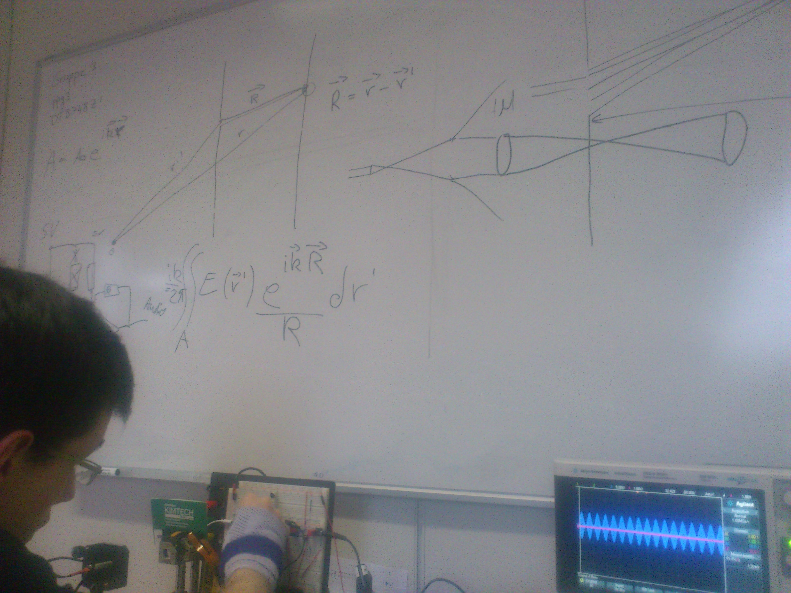
photos/DSC_0663.jpg
