ekiwi/iph/photos/DSC_0664.jpg

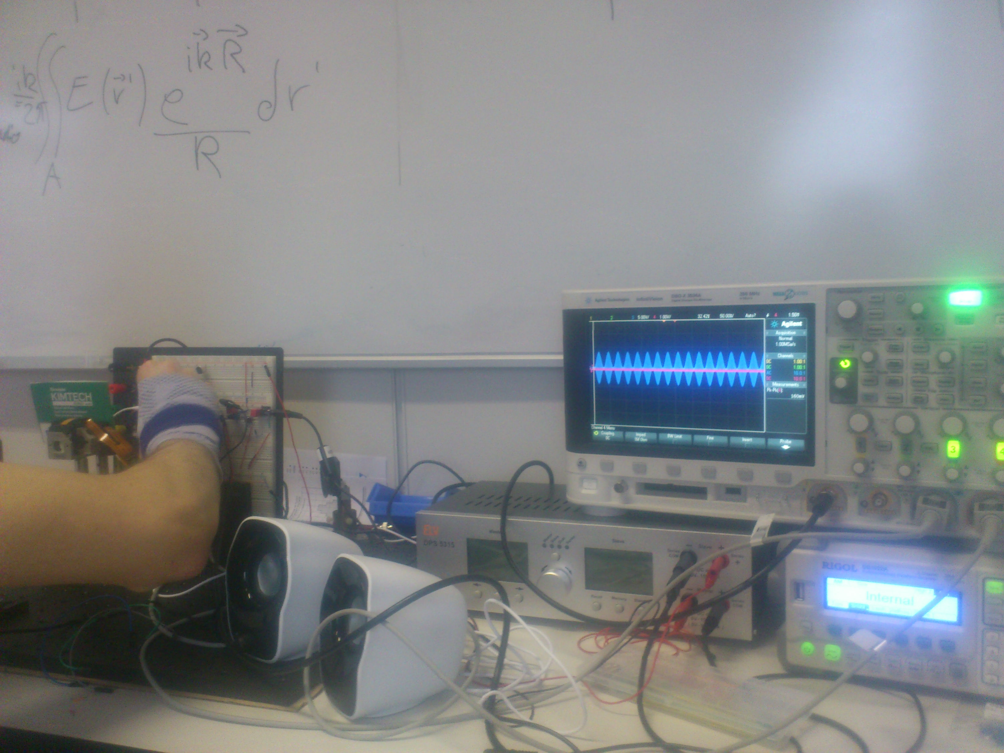
photos/DSC_0664.jpg
