ekiwi/iph/photos/DSC_0665.jpg

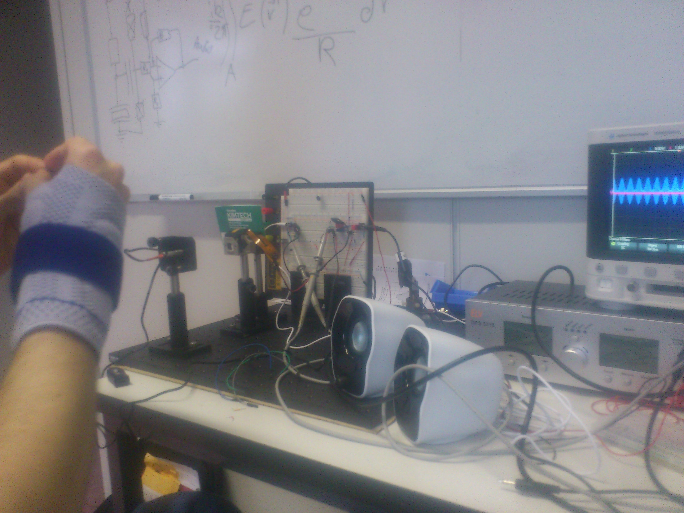
photos/DSC_0665.jpg
