ekiwi/iph/photos/IMG_20140522_171706.jpg

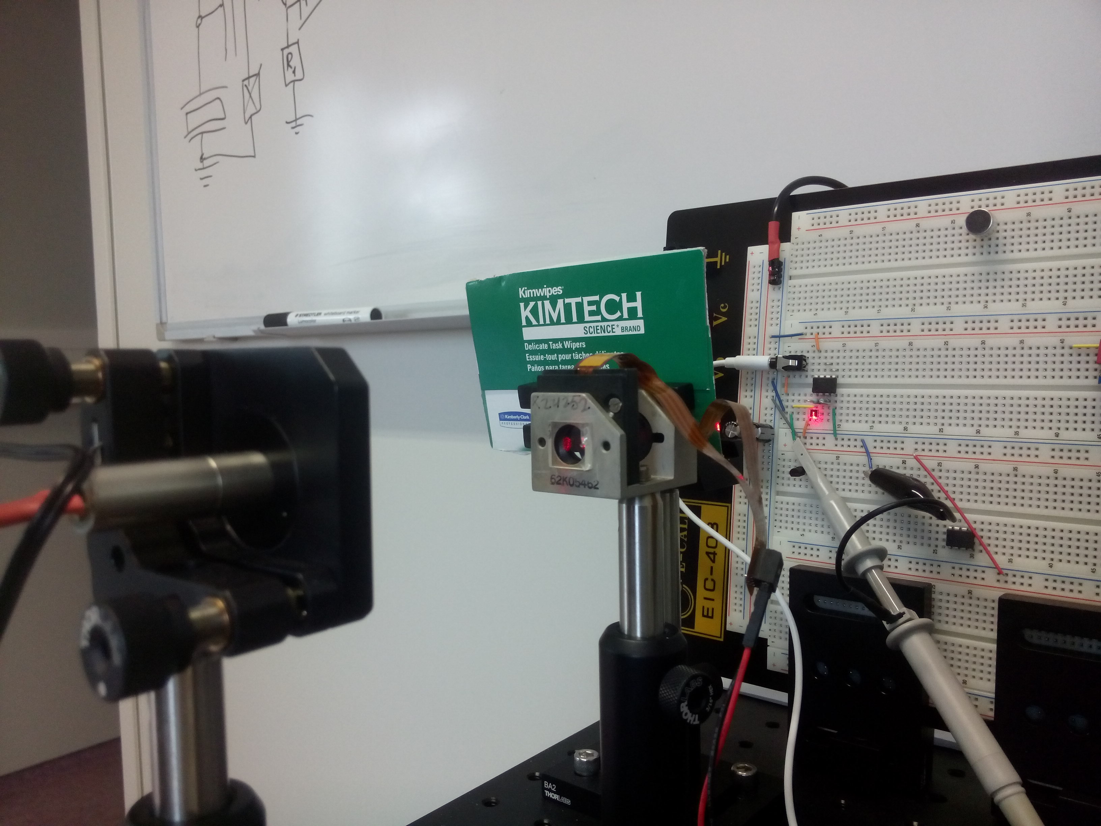
photos/IMG_20140522_171706.jpg
