ekiwi/iph/photos/IMG_20140522_171732.jpg

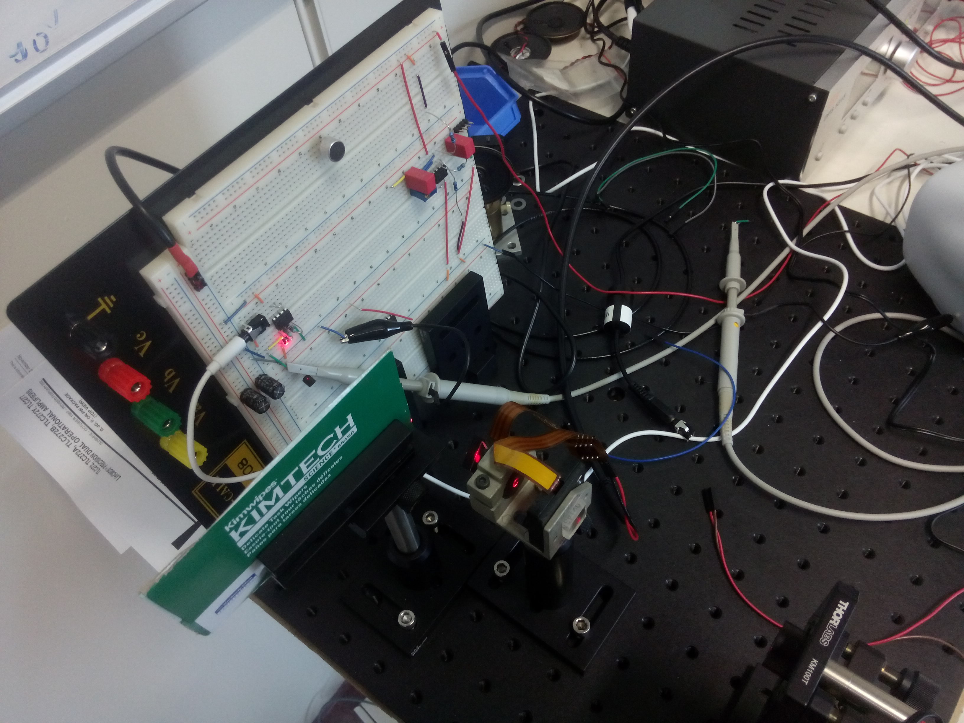
photos/IMG_20140522_171732.jpg
