ekiwi/iph/photos/IMG_20140522_171754.jpg

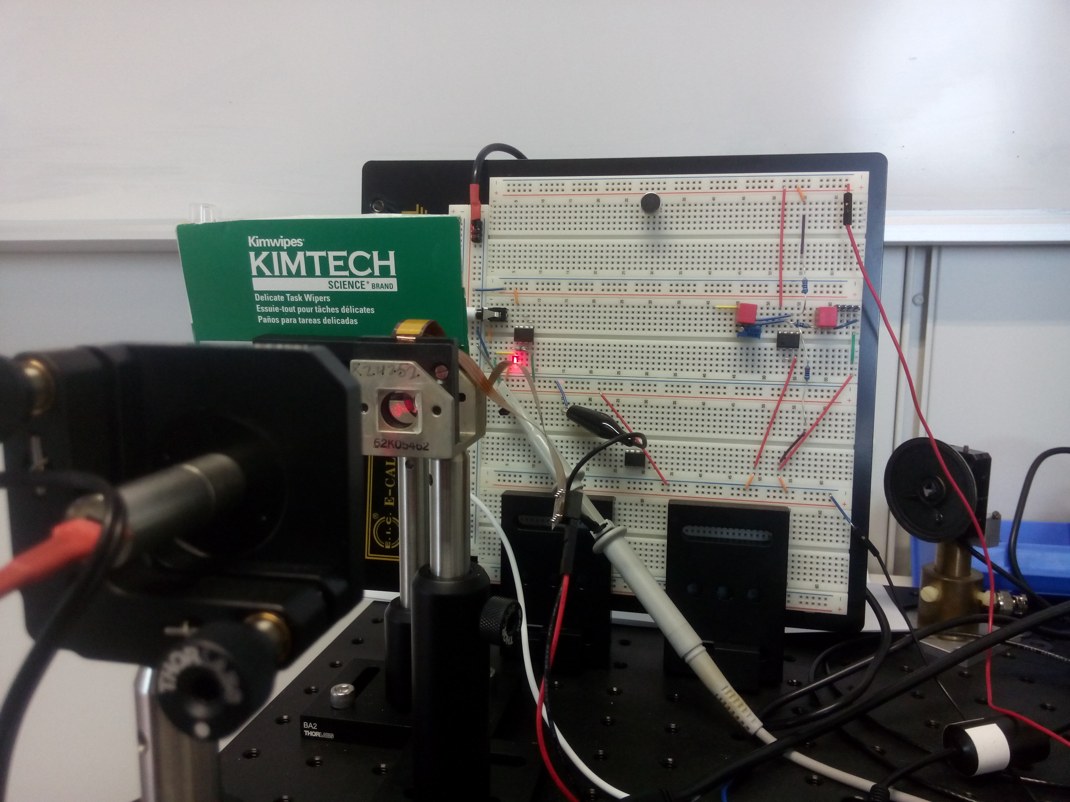
photos/IMG_20140522_171754.jpg
