ekiwi/iph/photos/IMG_20140522_171759.jpg

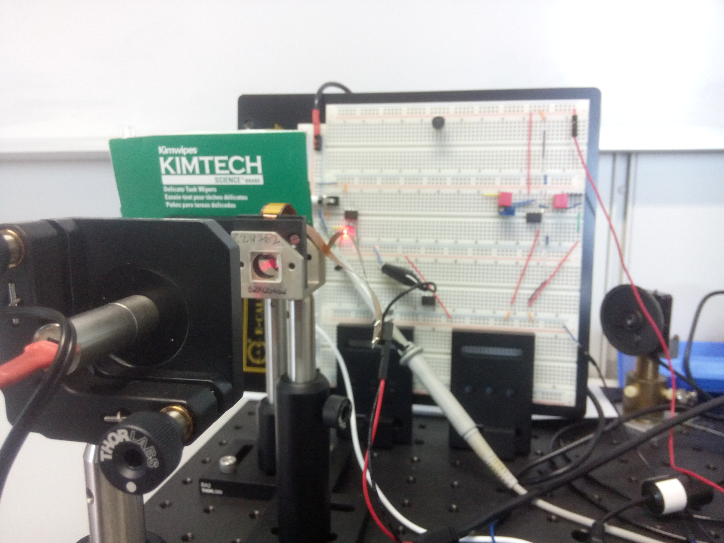
photos/IMG_20140522_171759.jpg
