ekiwi/iph/photos/IMG_20140703_173541.jpg

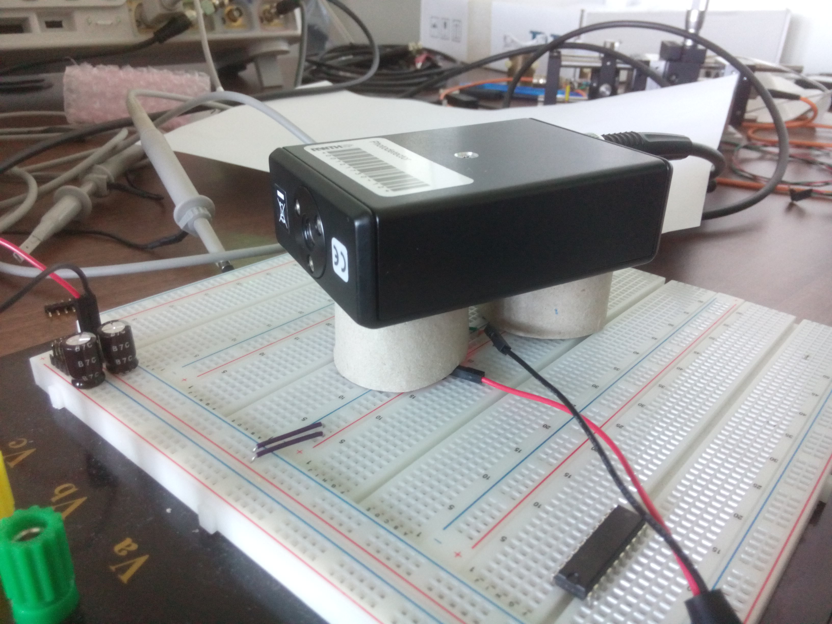
photos/IMG_20140703_173541.jpg
