ekiwi/iph/photos/IMG_20140703_173818.jpg

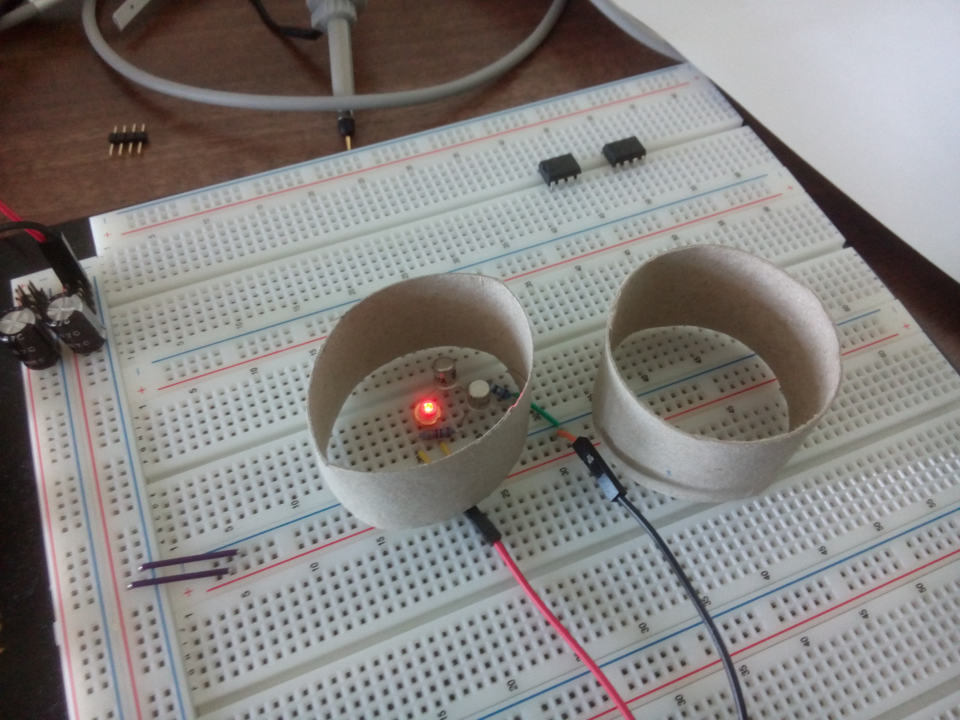
photos/IMG_20140703_173818.jpg
