ekiwi/iph/photos/IMG_20140710_184006.jpg

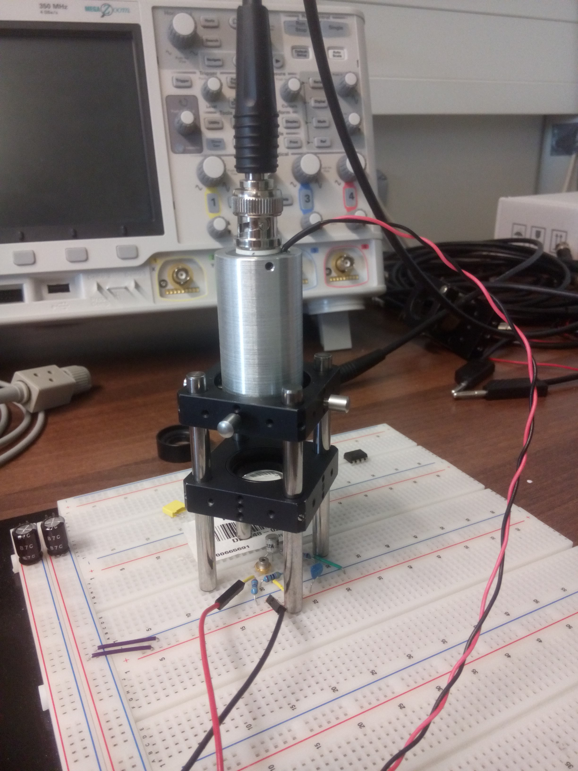
photos/IMG_20140710_184006.jpg
