ekiwi/iph/photos/IMG_20140710_184018.jpg

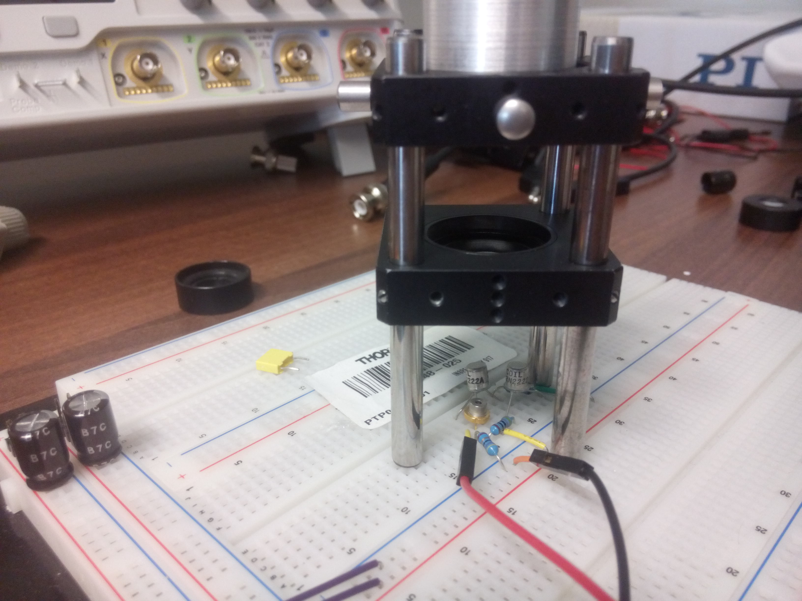
photos/IMG_20140710_184018.jpg
