ekiwi/iph/photos/IMG_20140710_184054.jpg

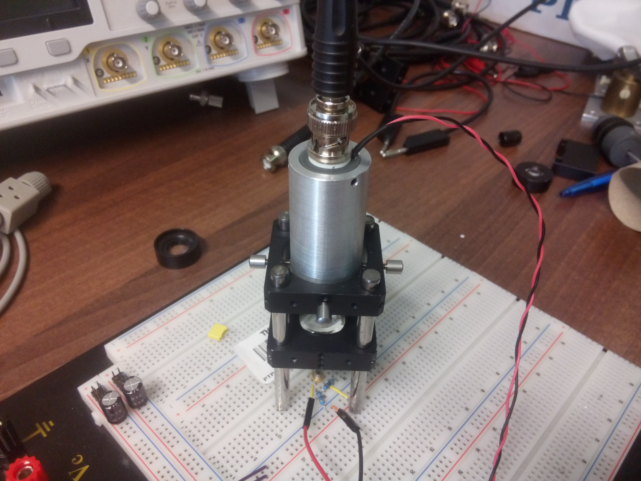
photos/IMG_20140710_184054.jpg
