ekiwi/iph/spice/current_input_v_current_out.png

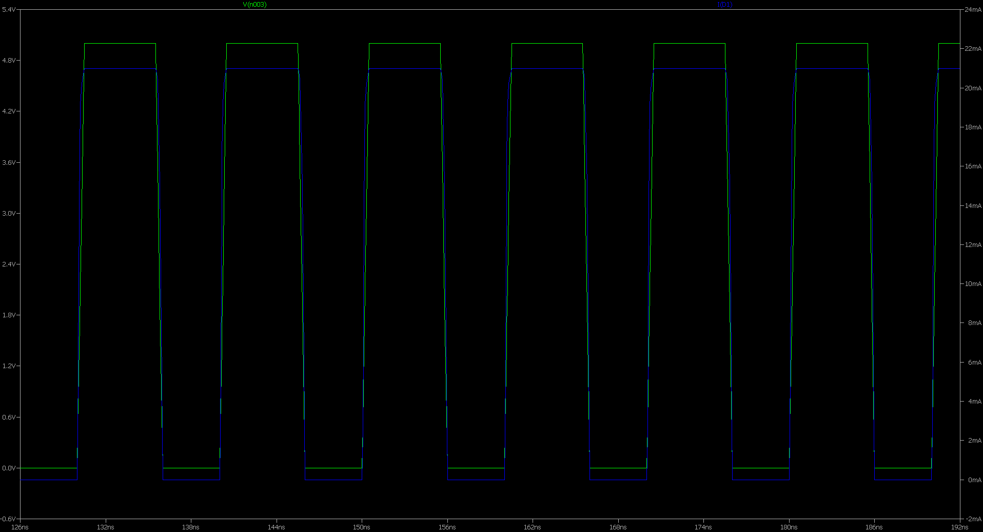
spice/current_input_v_current_out.png
