ekiwi/iph/measurements/20140502-08_erster_aufbau/scope_3.png

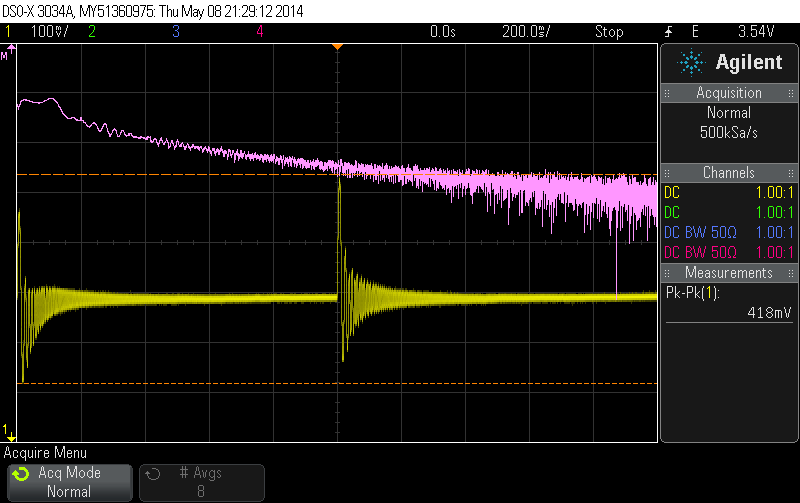
measurements/20140502-08_erster_aufbau/scope_3.png
