ekiwi/iph/measurements/20140502-08_erster_aufbau/scope_7.png

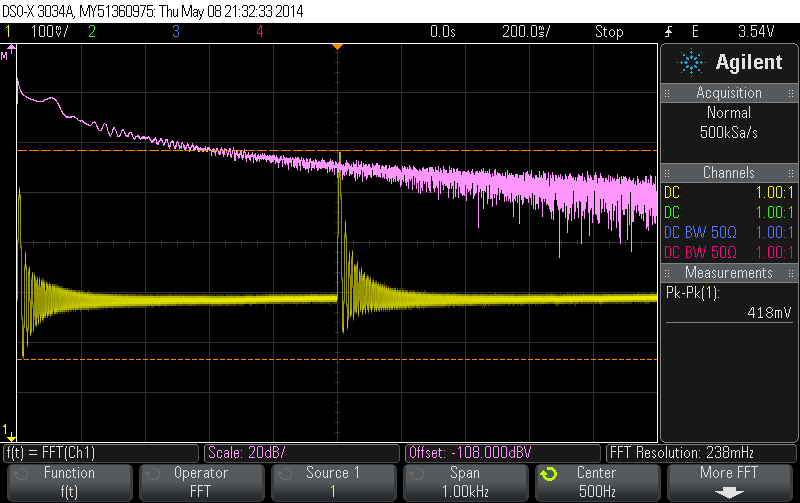
measurements/20140502-08_erster_aufbau/scope_7.png
