ekiwi/iph/measurements/20140710/Log.md

# scope 9-11
* signal generator output vs. optical output with different data frequencies

# scope 12-20
* eye diagrams
