ekiwi/iph/measurements/20140522_sweep/sweep.ods

Frequenz [Hz] | Spannung [mV] | Spannung [dB]
10 | 1190 | 61.5109392279
20 | 880 | 58.889653443
30 | 600 | 55.5630250077
40 | 480 | 53.6248247475
50 | 380 | 51.5956719323
70 | 300 | 49.5424250944
100 | 170 | 44.6089784276
200 | 95 | 39.5544721058
300 | 70 | 36.9019608003
400 | 60 | 35.5630250077
500 | 53 | 34.485517392
700 | 45 | 33.0642502755
1000 | 39 | 31.8212921405
