ekiwi/iph/measurements/20140703/20kHz_10kOhm/scope_3_2.csv

x-axis | 2
second | Volt
-9.69369884375e-005 | 5.02481
-9.68369884375e-005 | 5.03737
-9.67369884375e-005 | 5.04994
-9.66369884375e-005 | 5.01225
-9.65369884375e-005 | 5.03737
-9.64369884375e-005 | 4.99969
-9.63369884375e-005 | 4.99969
-9.62369884375e-005 | 5.03737
-9.61369884375e-005 | 4.99969
-9.60369884375e-005 | 5.01225
-9.59369884375e-005 | 5.03737
-9.58369884375e-005 | 5.03737
-9.57369884375e-005 | 5.03737
-9.56369884375e-005 | 5.02481
-9.55369884375e-005 | 5.01225
-9.54369884375e-005 | 5.01225
-9.53369884375e-005 | 5.03737
-9.52369884375e-005 | 5.03737
-9.51369884375e-005 | 5.02481
-9.50369884375e-005 | 5.01225
-9.49369884375e-005 | 5.01225
-9.48369884375e-005 | 5.01225
-9.47369884375e-005 | 5.02481
-9.46369884375e-005 | 5.03737
-9.45369884375e-005 | 5.01225
-9.44369884375e-005 | 5.04994
-9.43369884375e-005 | 5.04994
-9.42369884375e-005 | 5.03737
-9.41369884375e-005 | 5.0625
-9.40369884375e-005 | 5.03737
-9.39369884375e-005 | 5.02481
-9.38369884375e-005 | 5.02481
-9.37369884375e-005 | 5.01225
-9.36369884375e-005 | 5.02481
-9.35369884375e-005 | 4.99969
-9.34369884375e-005 | 5.01225
-9.33369884375e-005 | 5.03737
-9.32369884375e-005 | 5.02481
-9.31369884375e-005 | 5.03737
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
