ekiwi/iph/measurements/20140703/20kHz_10kOhm/scope_3_4.csv

x-axis | 4
second | Volt
-9.693696125e-005 | 0.0474915
-9.683696125e-005 | 0.0475291
-9.673696125e-005 | 0.0474915
-9.663696125e-005 | 0.0475794
-9.653696125e-005 | 0.0475668
-9.643696125e-005 | 0.0476171
-9.633696125e-005 | 0.0476799
-9.623696125e-005 | 0.047592
-9.613696125e-005 | 0.0476673
-9.603696125e-005 | 0.0477176
-9.593696125e-005 | 0.047705
-9.583696125e-005 | 0.0476799
-9.573696125e-005 | 0.0478055
-9.563696125e-005 | 0.0478432
-9.553696125e-005 | 0.0478683
-9.543696125e-005 | 0.0479186
-9.533696125e-005 | 0.0478683
-9.523696125e-005 | 0.047906
-9.513696125e-005 | 0.0478809
-9.503696125e-005 | 0.0479437
-9.493696125e-005 | 0.0479688
-9.483696125e-005 | 0.047994
-9.473696125e-005 | 0.0479688
-9.463696125e-005 | 0.0480317
-9.453696125e-005 | 0.0480442
-9.443696125e-005 | 0.048107
-9.433696125e-005 | 0.0480442
-9.423696125e-005 | 0.0481824
-9.413696125e-005 | 0.0481573
-9.403696125e-005 | 0.0481698
-9.393696125e-005 | 0.0482201
-9.383696125e-005 | 0.048308
-9.373696125e-005 | 0.0482578
-9.363696125e-005 | 0.0483709
-9.353696125e-005 | 0.0482829
-9.343696125e-005 | 0.0483332
-9.333696125e-005 | 0.0483332
-9.323696125e-005 | 0.048308
-9.313696125e-005 | 0.0483834
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
