ekiwi/iph/measurements/20140703/20kHz_50_Ohm/scope_1_1.csv

x-axis | 1
second | Volt
-9.6937000625e-005 | -0.00101507
-9.6837000625e-005 | -1.00732e-005
-9.6737000625e-005 | -0.0005126
-9.6637000625e-005 | -1.00732e-005
-9.6537000625e-005 | -1.00732e-005
-9.6437000625e-005 | -0.00151759
-9.6337000625e-005 | -1.00732e-005
-9.6237000625e-005 | -1.00732e-005
-9.6137000625e-005 | -0.0005126
-9.6037000625e-005 | -0.0005126
-9.5937000625e-005 | -0.00151759
-9.5837000625e-005 | -1.00732e-005
-9.5737000625e-005 | 0.00099498
-9.5637000625e-005 | -1.00732e-005
-9.5537000625e-005 | 0.000492454
-9.5437000625e-005 | -0.00101507
-9.5337000625e-005 | -0.00151759
-9.5237000625e-005 | 0.00099498
-9.5137000625e-005 | -1.00732e-005
-9.5037000625e-005 | 0.00099498
-9.4937000625e-005 | 0.000492454
-9.4837000625e-005 | -0.0005126
-9.4737000625e-005 | 0.00099498
-9.4637000625e-005 | -0.00101507
-9.4537000625e-005 | -1.00732e-005
-9.4437000625e-005 | -0.00101507
-9.4337000625e-005 | -1.00732e-005
-9.4237000625e-005 | 0.00099498
-9.4137000625e-005 | -0.0005126
-9.4037000625e-005 | 0.00099498
-9.3937000625e-005 | -0.00151759
-9.3837000625e-005 | -1.00732e-005
-9.3737000625e-005 | -0.0005126
-9.3637000625e-005 | -0.00101507
-9.3537000625e-005 | -1.00732e-005
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
