ekiwi/iph/measurements/20140703/20kHz_50_Ohm/scope_1_4.csv

x-axis | 4
second | Volt
-9.693696125e-005 | 0.00081407
-9.683696125e-005 | 0.00079397
-9.673696125e-005 | 0.000864322
-9.663696125e-005 | 0.000904523
-9.653696125e-005 | 0.000864322
-9.643696125e-005 | 0.000954774
-9.633696125e-005 | 0.000854271
-9.623696125e-005 | 0.000924623
-9.613696125e-005 | 0.000904523
-9.603696125e-005 | 0.000934673
-9.593696125e-005 | 0.000954774
-9.583696125e-005 | 0.000954774
-9.573696125e-005 | 0.000934673
-9.563696125e-005 | 0.000944724
-9.553696125e-005 | 0.000964824
-9.543696125e-005 | 0.000984925
-9.533696125e-005 | 0.000984925
-9.523696125e-005 | 0.00102513
-9.513696125e-005 | 0.00107538
-9.503696125e-005 | 0.00103518
-9.493696125e-005 | 0.000984925
-9.483696125e-005 | 0.00101508
-9.473696125e-005 | 0.00103518
-9.463696125e-005 | 0.00110553
-9.453696125e-005 | 0.00103518
-9.443696125e-005 | 0.00103518
-9.433696125e-005 | 0.00108543
-9.423696125e-005 | 0.00106533
-9.413696125e-005 | 0.00107538
-9.403696125e-005 | 0.00105528
-9.393696125e-005 | 0.00112563
-9.383696125e-005 | 0.00111558
-9.373696125e-005 | 0.00108543
-9.363696125e-005 | 0.00106533
-9.353696125e-005 | 0.00108543
-9.343696125e-005 | 0.00104523
-9.333696125e-005 | 0.00114573
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
