ekiwi/iph/measurements/20140611/4Hz_falling_edge/scope_7.csv

x-axis | 1 | 2 | 3
second | Volt | Volt | Volt
+15.6325000E+00
+15.6327500E+00
+15.6330000E+00 | +2.8179647E+00 | +3.6268844E+00 | +2.8258795E+00
+15.6332500E+00 | +2.8732410E+00 | +3.6896985E+00 | +2.9062816E+00
+15.6335000E+00 | +2.8983667E+00 | +3.7776382E+00 | +2.8861811E+00
+15.6337500E+00 | +2.8983667E+00 | +3.7776382E+00 | +2.9464826E+00
+15.6340000E+00 | +2.8380652E+00 | +3.8278894E+00 | +2.8258795E+00
+15.6342500E+00 | +2.8732410E+00 | +3.8278894E+00 | +2.8258795E+00
+15.6345000E+00 | +2.8179647E+00 | +3.6896985E+00 | +2.9062816E+00
+15.6347500E+00 | +2.8179647E+00 | +3.8278894E+00 | +2.8861811E+00
+15.6350000E+00 | +2.9184672E+00 | +3.6896985E+00 | +2.9314072E+00
+15.6352500E+00 | +2.8983667E+00 | +3.8278894E+00 | +2.8510052E+00
+15.6355000E+00 | +2.8179647E+00 | +3.7776382E+00 | +2.9062816E+00
+15.6357500E+00 | +2.9184672E+00 | +3.7776382E+00 | +2.8861811E+00
+15.6360000E+00 | +2.8983667E+00 | +3.8278894E+00 | +2.9062816E+00
+15.6362500E+00 | +2.8732410E+00 | +3.6896985E+00 | +2.9062816E+00
+15.6365000E+00 | +2.8732410E+00 | +3.6268844E+00 | +2.9062816E+00
+15.6367500E+00 | +2.8380652E+00 | +3.6268844E+00 | +2.9062816E+00
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
