ekiwi/iph/measurements/20140611/4Hz_rising_edge/scope_3.csv

x-axis | 1 | 2 | 3
second | Volt | Volt | Volt
+12.5670000E+00
+12.5675000E+00 | -76.5077E-03 | +3.7525125E+00 | +11.8092E-03
+12.5680000E+00 | -26.2564E-03 | +3.8278894E+00 | -13.3164E-03
+12.5685000E+00 | -106.6584E-03 | +3.6268844E+00 | -68.5928E-03
+12.5690000E+00 | -156.9097E-03 | +3.7022613E+00 | -68.5928E-03
+12.5695000E+00 | -131.7841E-03 | +3.8278894E+00 | +11.8092E-03
+12.5700000E+00 | -76.5077E-03 | +3.9660804E+00 | +11.8092E-03
+12.5705000E+00 | -76.5077E-03 | +3.8278894E+00 | -68.5928E-03
+12.5710000E+00 | -76.5077E-03 | +3.8278894E+00 | -68.5928E-03
+12.5715000E+00 | -76.5077E-03 | +3.8278894E+00 | -13.3164E-03
+12.5720000E+00 | -156.9097E-03 | +3.7022613E+00 | -118.8440E-03
+12.5725000E+00 | -76.5077E-03 | +3.8278894E+00 | -13.3164E-03
+12.5730000E+00 | -76.5077E-03 | +3.8278894E+00 | -68.5928E-03
+12.5735000E+00 | -76.5077E-03 | +3.9660804E+00 | -38.4420E-03
+12.5740000E+00 | -76.5077E-03 | +3.7022613E+00 | +11.8092E-03
+12.5745000E+00 | -131.7841E-03 | +3.8278894E+00 | -68.5928E-03
+12.5750000E+00 | -106.6584E-03 | +3.7022613E+00 | -13.3164E-03
+12.5755000E+00 | -106.6584E-03 | +3.8278894E+00 | +11.8092E-03
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
