ekiwi/iph/measurements/20140610/3Hz_comparator_output/scope_9.csv

x-axis | 1 | 3
second | Volt | Volt
-2.500000E+00 | +4.206784E+00 | -5.030465E+00
-2.497500E+00 | +4.206784E+00 | -5.231470E+00
-2.495000E+00 | +4.206784E+00 | -5.143530E+00
-2.492500E+00 | +4.206784E+00 | -5.181219E+00
-2.490000E+00 | +4.206784E+00 | -5.231470E+00
-2.487500E+00 | +4.226884E+00 | -5.231470E+00
-2.485000E+00 | +4.206784E+00 | -5.231470E+00
-2.482500E+00 | +4.206784E+00 | -5.231470E+00
-2.480000E+00 | +4.206784E+00 | -5.231470E+00
-2.477500E+00 | +4.206784E+00 | -5.193781E+00
-2.475000E+00 | +4.206784E+00 | -5.231470E+00
-2.472500E+00 | +4.206784E+00 | -5.231470E+00
-2.470000E+00 | +4.206784E+00 | -5.043028E+00
-2.467500E+00 | +4.206784E+00 | -5.231470E+00
-2.465000E+00 | +4.206784E+00 | -5.143530E+00
-2.462500E+00 | +4.231909E+00 | -5.093279E+00
-2.460000E+00 | +4.206784E+00 | -5.231470E+00
-2.457500E+00 | +4.206784E+00 | -5.193781E+00
-2.455000E+00 | +4.287186E+00 | -5.143530E+00
-2.452500E+00 | +4.267085E+00 | -5.231470E+00
-2.450000E+00 | +4.287186E+00 | -5.043028E+00
-2.447500E+00 | +4.226884E+00 | -5.231470E+00
-2.445000E+00 | +4.252010E+00 | -5.030465E+00
-2.442500E+00 | +4.206784E+00 | -5.231470E+00
-2.440000E+00 | +4.206784E+00 | -5.231470E+00
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
