ekiwi/iph/measurements/20140610/10Hz_random/scope_5.csv

x-axis | 2 | 3 | 4
second | Volt | Volt | Volt
-2.493600E+00
-2.491100E+00 | +209.329E-03 | -5.128141E+00 | +201.005E-03
-2.488600E+00 | +216.867E-03 | -5.015075E+00 | -364.322E-03
-2.486100E+00 | +213.098E-03 | -5.015075E+00 | -25.126E-03
-2.483600E+00 | +200.535E-03 | -5.015075E+00 | -201.005E-03
-2.481100E+00 | +225.661E-03 | -5.090452E+00 | +75.377E-03
-2.478600E+00 | +210.585E-03 | -5.216080E+00 | -201.005E-03
-2.476100E+00 | +213.098E-03 | -5.015075E+00 | +201.005E-03
-2.473600E+00 | +206.817E-03 | -5.140704E+00 | -62.814E-03
-2.471100E+00 | +213.098E-03 | -5.015075E+00 | -226.131E-03
-2.468600E+00 | +196.766E-03 | -5.015075E+00 | +201.005E-03
-2.466100E+00 | +195.510E-03 | -5.027638E+00 | -339.196E-03
-2.463600E+00 | +206.817E-03 | -5.015075E+00 | -62.814E-03
-2.461100E+00 | +185.460E-03 | -5.015075E+00 | +201.005E-03
-2.458600E+00 | +192.997E-03 | -5.178392E+00 | +201.005E-03
-2.456100E+00 | +176.666E-03 | -5.027638E+00 | +163.317E-03
-2.453600E+00 | +192.997E-03 | -5.077889E+00 | +0.0E+00
-2.451100E+00 | +192.997E-03 | -5.090452E+00 | -276.382E-03
-2.448600E+00 | +190.485E-03 | -5.216080E+00 | +163.317E-03
-2.446100E+00 | +175.410E-03 | -5.027638E+00 | +201.005E-03
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
