ekiwi/iph/measurements/20140610/10Hz_toggle/scope_7.csv

x-axis | 2 | 3 | 4
second | Volt | Volt | Volt
-993.60E-03 | +186.72E-03 | +4.97236E+00 | -439.70E-03
-992.60E-03 | +174.15E-03 | +4.84673E+00 | +1.31910E+00
-991.60E-03 | +172.90E-03 | +4.83417E+00 | +2.55025E+00
-990.60E-03 | +172.90E-03 | +4.92211E+00 | +3.39196E+00
-989.60E-03 | +172.90E-03 | +4.83417E+00 | +2.33668E+00
-988.60E-03 | +171.64E-03 | +4.83417E+00 | +3.54271E+00
-987.60E-03 | +136.46E-03 | +4.83417E+00 | +2.60050E+00
-986.60E-03 | +132.70E-03 | +4.94724E+00 | +615.58E-03
-985.60E-03 | +146.52E-03 | +4.83417E+00 | +1.83417E+00
-984.60E-03 | +151.54E-03 | +4.83417E+00 | +3.55528E+00
-983.60E-03 | +149.03E-03 | +4.83417E+00 | +2.44975E+00
-982.60E-03 | +142.75E-03 | +4.83417E+00 | +992.46E-03
-981.60E-03 | +132.70E-03 | +4.83417E+00 | -276.38E-03
-980.60E-03 | +133.95E-03 | +4.83417E+00 | +665.83E-03
-979.60E-03 | +132.70E-03 | +4.98492E+00 | +1.99749E+00
-978.60E-03 | +152.80E-03 | +4.83417E+00 | +2.72613E+00
-977.60E-03 | +159.08E-03 | +4.83417E+00 | +2.55025E+00
-976.60E-03 | +154.05E-03 | +4.83417E+00 | +3.51759E+00
-975.60E-03 | +177.92E-03 | +4.83417E+00 | +1.75879E+00
-974.60E-03 | +182.95E-03 | +4.83417E+00 | -163.32E-03
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
