ekiwi/iph/measurements/20140610/uart_continous_key/scope_1.csv

x-axis | 2 | 3 | 4
second | Volt | Volt | Volt
-25.12000E-03 | +44.80528E-03 | +3.72763813E+00 | -1.54522614E+00
-25.09500E-03 | +49.57915E-03 | +3.70251250E+00 | +1.00502513E+00
-25.07000E-03 | +50.96106E-03 | +3.70251250E+00 | +2.97738696E+00
-25.04500E-03 | +50.83543E-03 | +3.70251250E+00 | +3.20351761E+00
-25.02000E-03 | +41.28770E-03 | +3.70251250E+00 | +1.53266333E+00
-24.99500E-03 | +47.94599E-03 | +3.70251250E+00 | -1.00502513E+00
-24.97000E-03 | +44.80528E-03 | +3.76783914E+00 | -3.01507540E+00
-24.94500E-03 | +43.54900E-03 | +3.70251250E+00 | -3.19095480E+00
-24.92000E-03 | +48.69976E-03 | +3.70251250E+00 | -1.60804021E+00
-24.89500E-03 | +47.31785E-03 | +3.70251250E+00 | +917.08543E-03
-24.87000E-03 | +48.69976E-03 | +3.75276376E+00 | +2.97738696E+00
-24.84500E-03 | +49.32790E-03 | +3.62713562E+00 | +3.02763821E+00
-24.82000E-03 | +46.56408E-03 | +3.70251250E+00 | +1.46984926E+00
-24.79500E-03 | +48.57413E-03 | +3.81306527E+00 | -1.00502513E+00
-24.77000E-03 | +46.43845E-03 | +3.75276376E+00 | -3.01507540E+00
-24.74500E-03 | +47.31785E-03 | +3.70753763E+00 | -3.21608043E+00
-24.72000E-03 | +42.66961E-03 | +3.75276376E+00 | -1.53266333E+00
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
