ekiwi/iph/measurements/20140610/uart_one_key/scope_3.csv

x-axis | 2 | 3 | 4
second | Volt | Volt | Volt
-18.60000E-03
-18.57500E-03 | -1.80276E-03 | +3.74271351E+00 | +2.09798997E+00
-18.55000E-03 | +1.08669E-03 | +3.70251250E+00 | +3.26633168E+00
-18.52500E-03 | +3.09674E-03 | +3.70251250E+00 | +2.61306535E+00
-18.50000E-03 | +3.59925E-03 | +3.70251250E+00 | +201.00503E-03
-18.47500E-03 | +4.22739E-03 | +3.65728637E+00 | -2.11055278E+00
-18.45000E-03 | +2.34297E-03 | +3.75778888E+00 | -3.35427138E+00
-18.42500E-03 | -672.10E-06 | +3.70251250E+00 | -2.61306535E+00
-18.40000E-03 | +2.71986E-03 | +3.76281401E+00 | -402.01005E-03
-18.37500E-03 | +2.97111E-03 | +3.70251250E+00 | +2.01005027E+00
-18.35000E-03 | +4.60428E-03 | +3.75778888E+00 | +3.41708545E+00
-18.32500E-03 | +2.97111E-03 | +3.78291451E+00 | +2.41206032E+00
-18.30000E-03 | -420.85E-06 | +3.70251250E+00 | +201.00503E-03
-18.27500E-03 | +961.06E-06 | +3.70251250E+00 | -2.09798997E+00
-18.25000E-03 | +584.18E-06 | +3.70251250E+00 | -3.41708545E+00
-18.22500E-03 | -923.36E-06 | +3.70251250E+00 | -2.61306535E+00
-18.20000E-03 | +332.92E-06 | +3.76281401E+00 | -402.01005E-03
-18.17500E-03 | +458.55E-06 | +3.73768838E+00 | +2.09798997E+00
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
