ekiwi/iph/measurements/20140522_sweep/plots.png

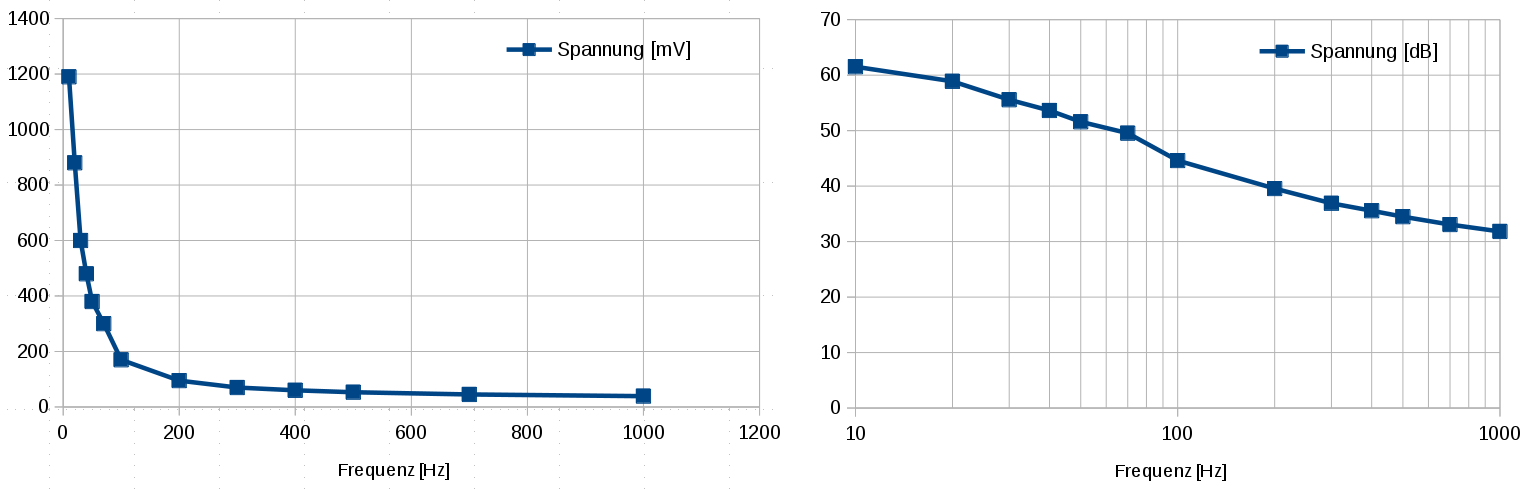
measurements/20140522_sweep/plots.png
