ekiwi/iph/measurements/20140522_sweep/scope_0.png

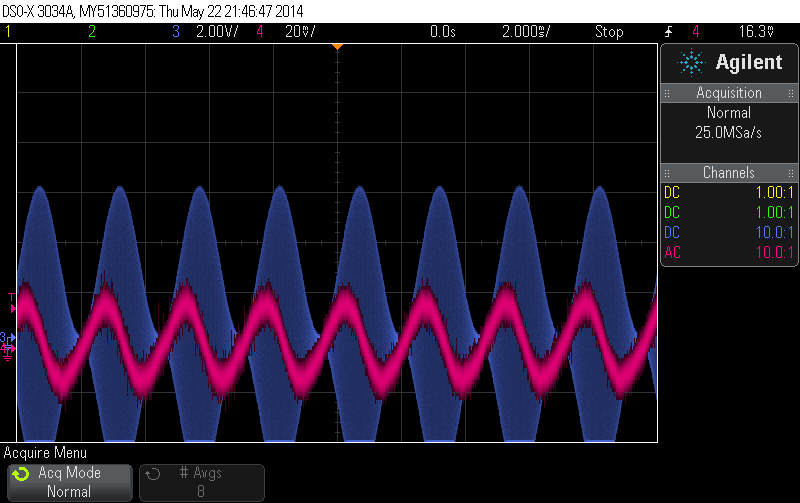
measurements/20140522_sweep/scope_0.png
