ekiwi/iph/measurements/20140610/3Hz_comparator_output/scope_8.png

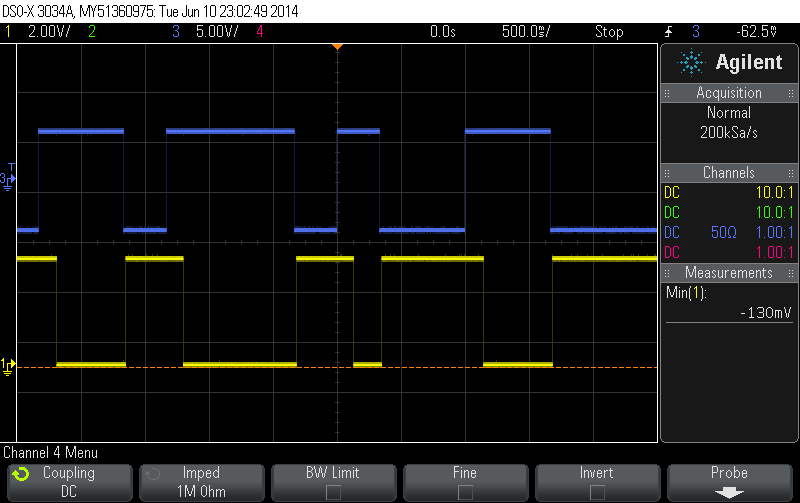
measurements/20140610/3Hz_comparator_output/scope_8.png
