ekiwi/iph/measurements/20140610/10Hz_random/demod_scope_5.png

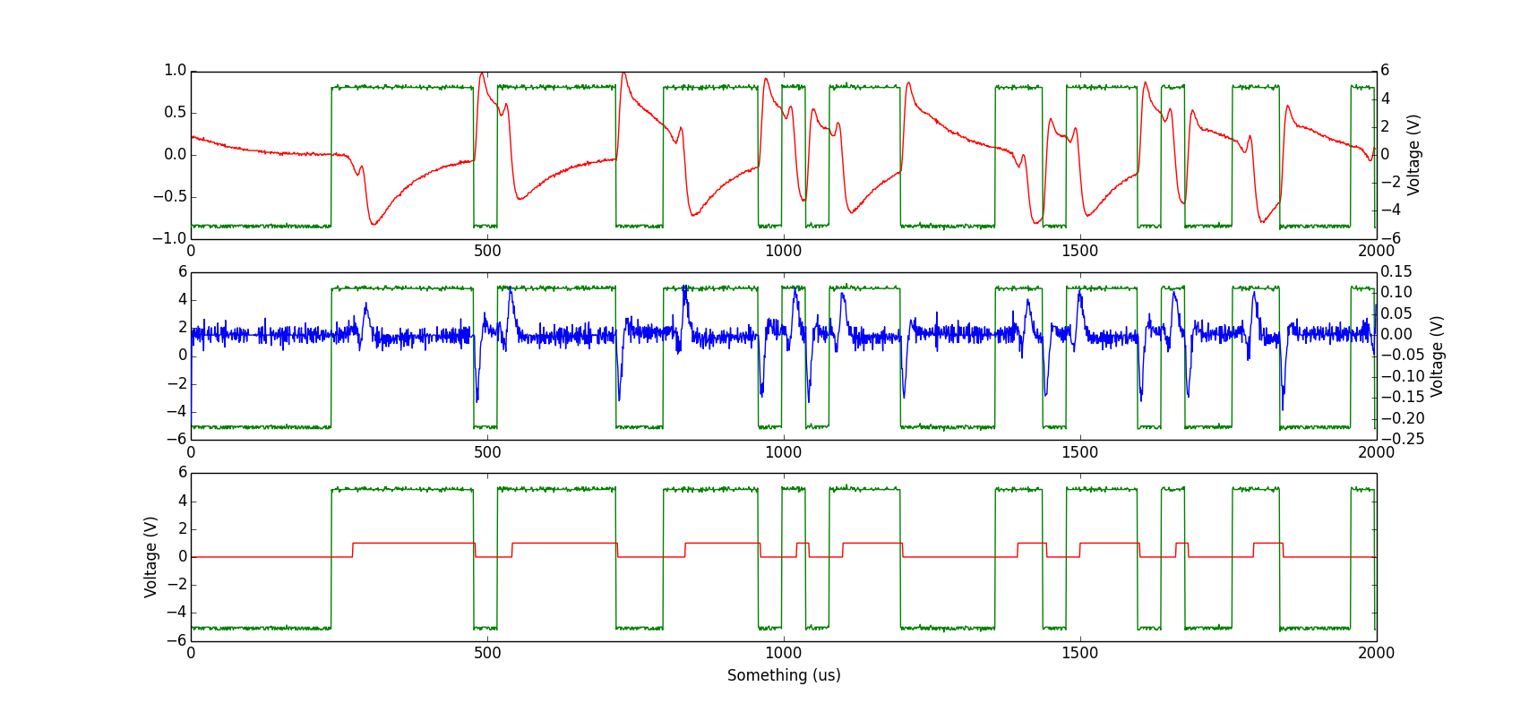
measurements/20140610/10Hz_random/demod_scope_5.png
