ekiwi/iph/measurements/20140611/4Hz_rising_edge/scope_4.png

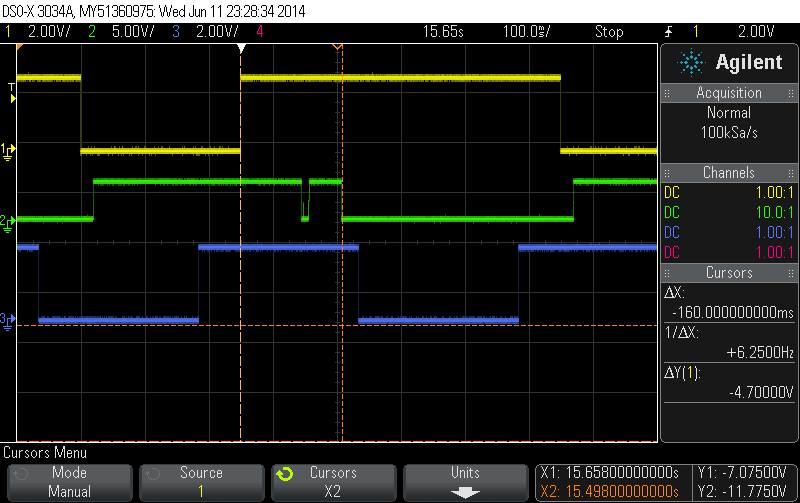
measurements/20140611/4Hz_rising_edge/scope_4.png
