ekiwi/iph/measurements/20140710/1MHz_random_data/scope_7.png

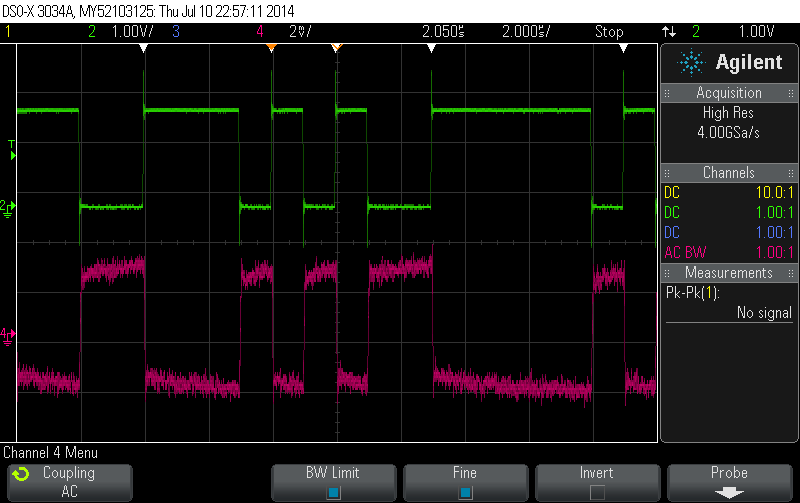
measurements/20140710/1MHz_random_data/scope_7.png
