ekiwi/iph/measurements/20140710/2MHz_random_data/scope_8.png

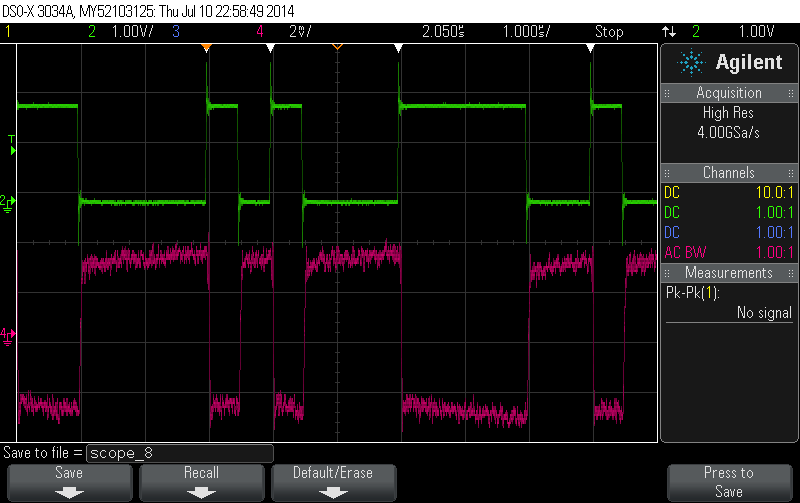
measurements/20140710/2MHz_random_data/scope_8.png
