ekiwi/iph/measurements/20140710/5MHz_random_data/scope_9.png

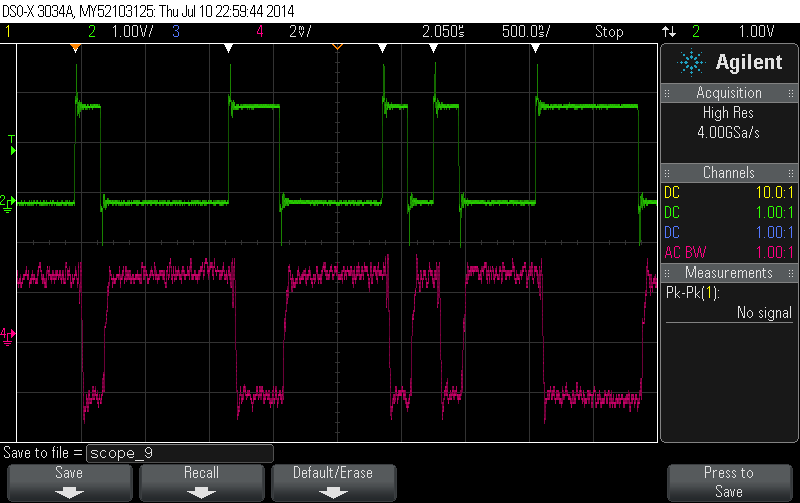
measurements/20140710/5MHz_random_data/scope_9.png
