ekiwi/iph/measurements/20140710/10MHz_random_data/scope_10.png

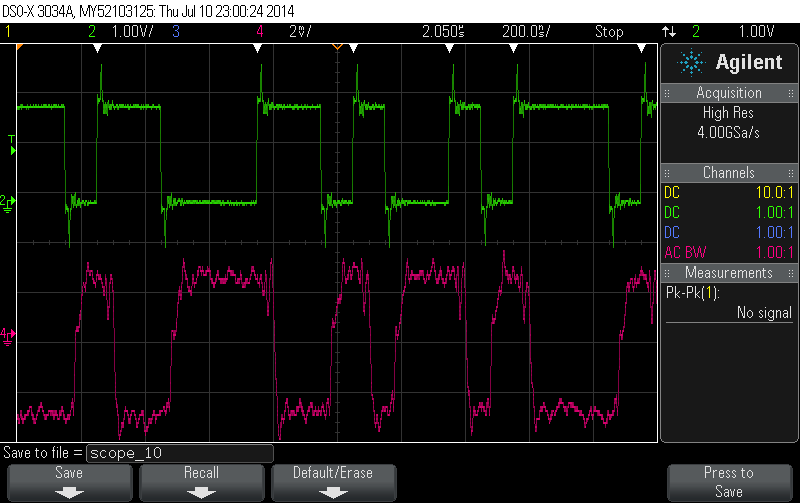
measurements/20140710/10MHz_random_data/scope_10.png
