ekiwi/iph/measurements/20140710/20MHz_random_data/scope_2.png

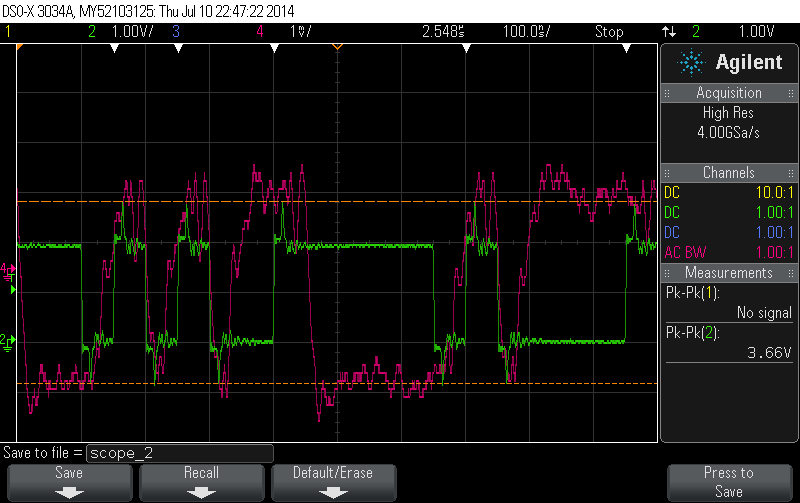
measurements/20140710/20MHz_random_data/scope_2.png
