ekiwi/iph/measurements/20140710/20MHz_random_data/scope_3.png

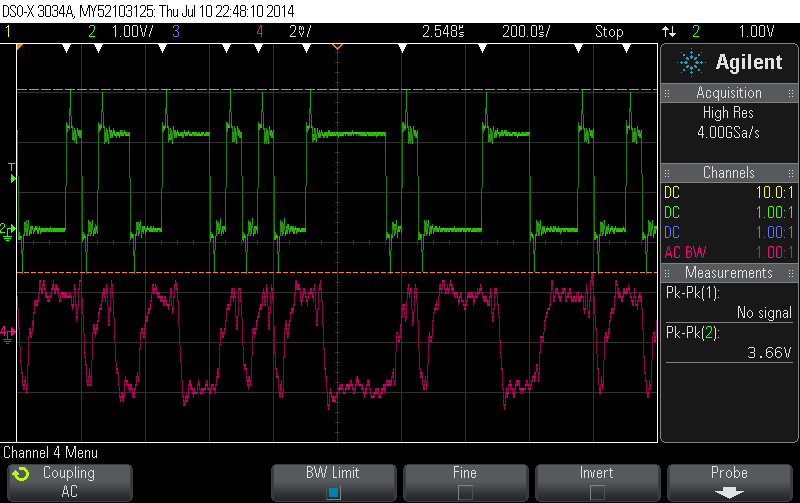
measurements/20140710/20MHz_random_data/scope_3.png
