ekiwi/iph/measurements/20140710/20MHz_random_data/scope_4.png

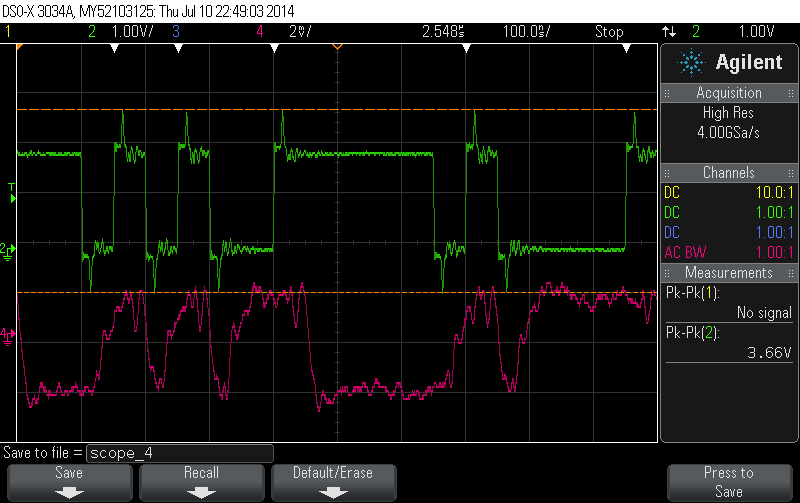
measurements/20140710/20MHz_random_data/scope_4.png
