ekiwi/iph/measurements/20140710/20MHz_random_data/scope_11.png

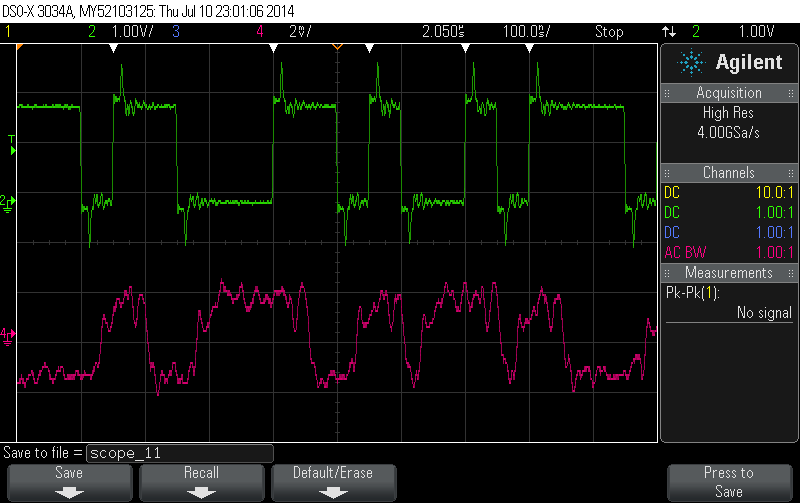
measurements/20140710/20MHz_random_data/scope_11.png
