ekiwi/iph/measurements/20140710/eye_plots/02MHz.png

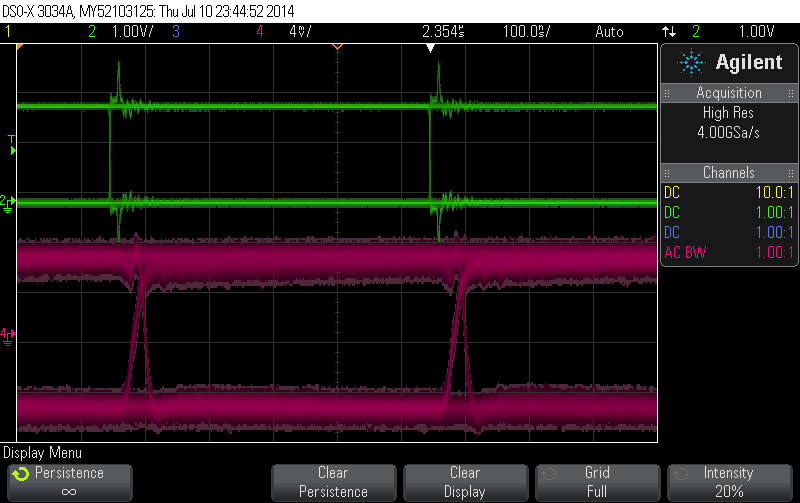
measurements/20140710/eye_plots/02MHz.png
