ekiwi/iph/measurements/20140710/eye_plots/05MHz.png

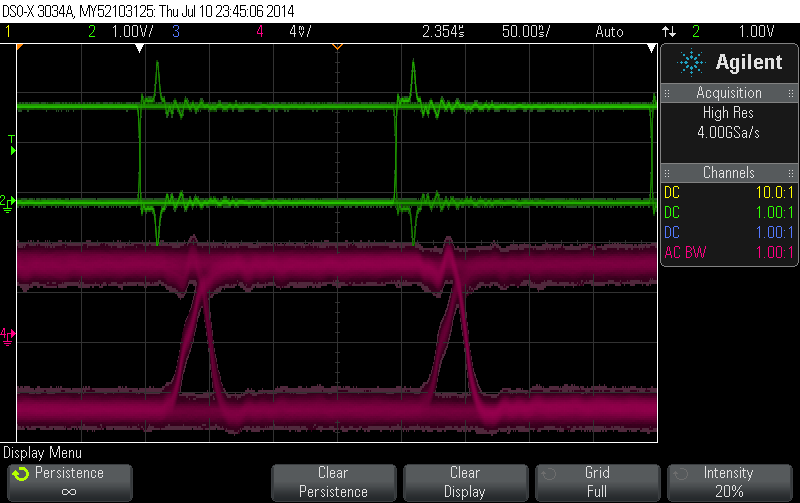
measurements/20140710/eye_plots/05MHz.png
