ekiwi/iph/measurements/20140710/eye_plots/20MHz.png

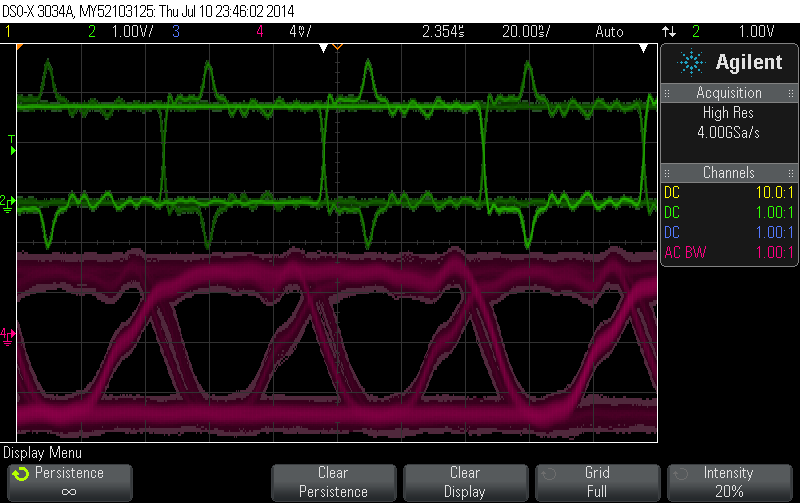
measurements/20140710/eye_plots/20MHz.png
