ekiwi/iph/measurements/20140710/eye_plots/40MHz.png

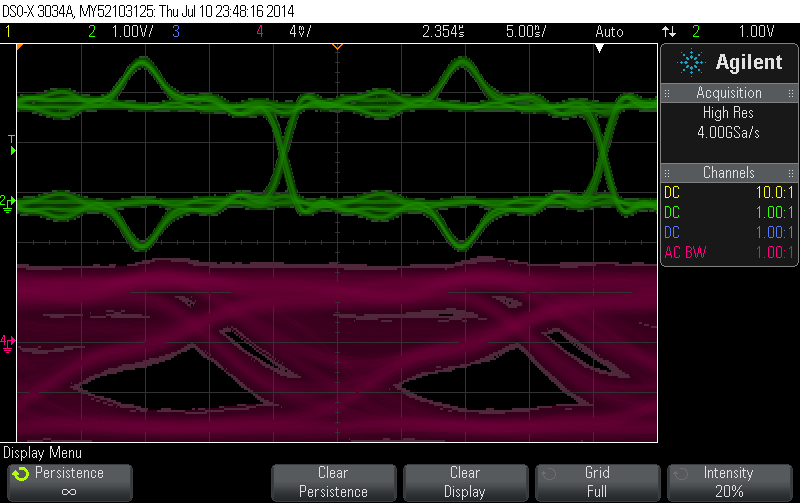
measurements/20140710/eye_plots/40MHz.png
