ekiwi/iph/measurements/20140710/eye_plots/60MHz.png

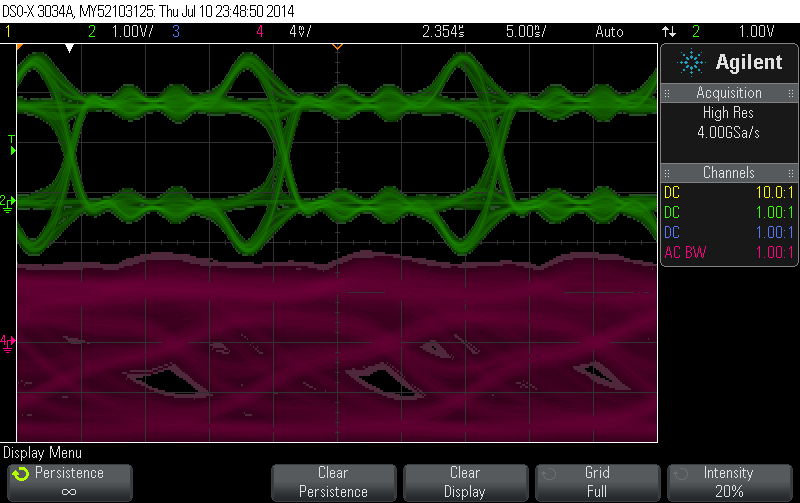
measurements/20140710/eye_plots/60MHz.png
