ekiwi/iph/Todo.md

# Todo

## Analog Link
* audio transmission: with AM modulation, record
* UART transmission with +/-5V Opamp as comparator

## Digital Link
