ekiwi/iph/report/img/receiver.pdf

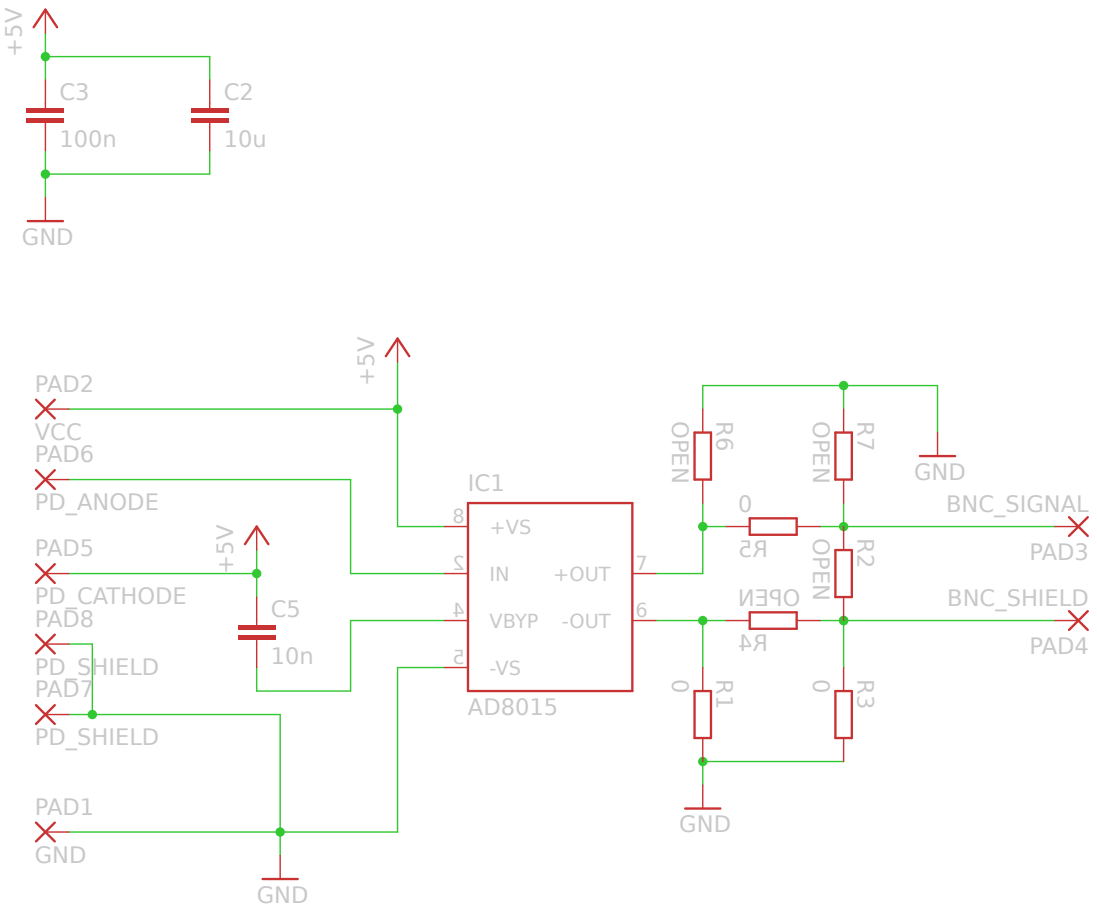
[picture p78: page 1]
