ekiwi/iph/spice/modulated_current_source.asc

D1: LED; NSPW500BS
Q1: npn
Q2: npn
R1: res; 39R
R2: res; 470R
V1: voltage; 5V
V2: voltage; PULSE(0 5V 0 0 0 5n 10n)
Named nets: 0
.tran 1u
