ekiwi/iph/spice/lcd02.asc

C1: cap; 100n
C2: cap; 100n
R1: res; 150k
R2: res; 300k
R3: res; 10
R4: res; 1MEG
R5: res; 1MEG
U1: TS912
U2: TS912
V1: voltage; PWL file=Z:\home\kevin\institus_project\source.csv
V2: voltage; 12
V3: voltage; 12
V4: voltage; 12
V5: voltage; SINE(1 1 200)
Named nets: 0, Out
.tran 2
