ekiwi/iph/eagle/receiver.brd

## EAGLE design eagle/receiver.brd (2014-06-20)

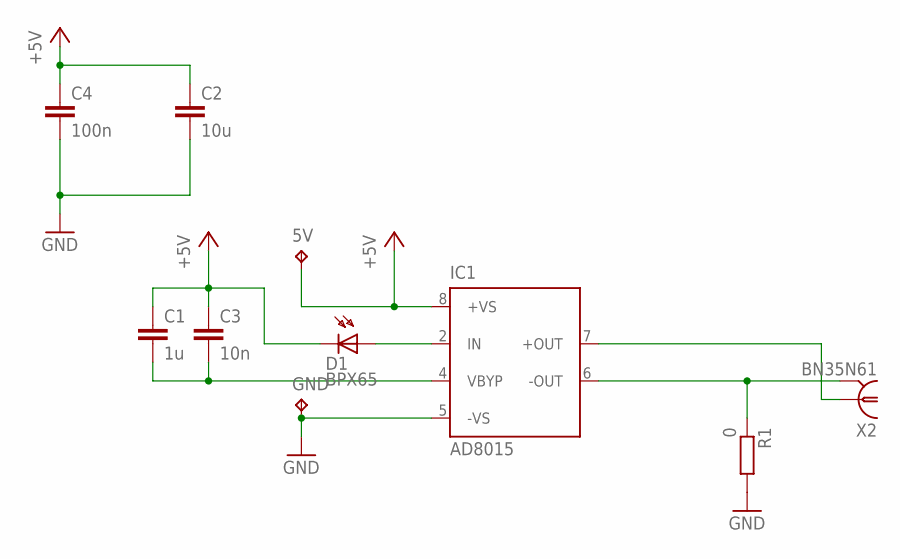
[picture p79: schematic receiver.sch]

Parts:
5V: TPTP20SQ; TP20SQ
C1: 1u; C1206
C2: 10u; C1206
C3: 10n; C0603
C4: 100n; C0603
D1: BPX65
GND: TPTP20SQ; TP20SQ
IC1: AD8015; SO8
R1: 0; R1206
X2: BN35N61; B35N61

Connections:
+5V: 5V.TP, C1.1, C2.1, C3.1, C4.1, D1.K (C), IC1.8 (+VS)
GND: C2.2, C4.2, GND.TP, IC1.5 (-VS), R1.2
unnamed: C1.2, C3.2, IC1.4 (VBYP)
unnamed: IC1.7 (+OUT), X2.1
unnamed: IC1.6 (-OUT), R1.1, X2.2, X2.3 (2), X2.4 (2), X2.5 (2)
unnamed: D1.A, IC1.2 (IN)

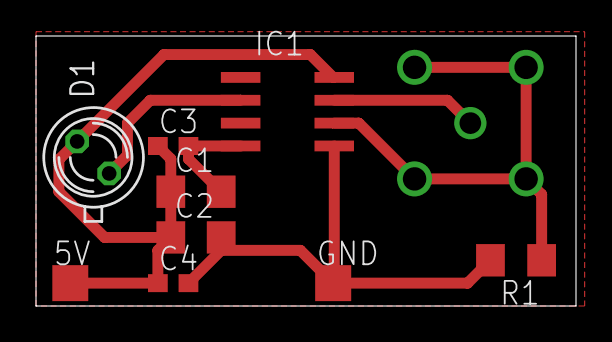
[picture p80: board receiver.brd from above]

Board: 2 copper layers, 30.0 x 15.0 mm, 10 parts (1 on the bottom side), 6 nets.
