ekiwi/iph/(commit log)

2014-06-10 Spice: add signal source file
    [source.csv]
2014-06-10 Measurements: add data
    [scope_1.csv, scope_2_1.csv, scope_4.csv, scope_5.csv, scope_6_1.csv, sweep.ods]
2014-06-10 New measurements.
    [scope_1.csv, scope_3.csv, scope_5.csv, scope_7.csv]
2014-06-10 Stm32: source for lcd transmitter
    [project.cfg]
2014-06-10 AC coupling on measurement results
2014-06-10 Measurement: 3Hz with comparator on output
    [scope_9.csv]
2014-06-11 Lcd Link: uart output working
    [project.cfg]
2014-06-11 Tx: let's just reimplement UART ...
2014-06-11 Receiver source
    [project.cfg]
2014-06-11 New measurements added
    [scope_1.csv, scope_3.csv, scope_5.csv, scope_7.csv]
2014-06-20 Added receiver schematics / board layout
    [receiver.brd, receiver.sch]
2014-07-10 Receiver: toggle pin when sampling
2014-07-10 Measurements: 2014-07-03
    [scope_1_1.csv, scope_1_2.csv, scope_1_4.csv, scope_3_1.csv, scope_3_2.csv, scope_3_4.csv]
2014-07-12 Improve sweep document
    [sweep.ods]
2014-07-16 Spice/Presentation: add modulated current source
2014-07-16 Corrected some folder names (mainly to try out git mv...)
    [scope_1_1.csv, scope_1_2.csv, scope_1_4.csv, scope_3_1.csv, scope_3_2.csv, scope_3_4.csv]
2014-07-16 Presentation: add software UART
2014-07-17 UART: add data format
2014-07-17 UART: fix pie chart
2014-08-03 Final version of the sweep spreadsheet
    [sweep.ods]
2014-08-14 report: Added a basic LCD frequency response plot
    [2.1_lcd_sweep_data.csv]
2014-08-29 Report: add receiver schematic
2014-08-29 Report: add UART figures
2014-08-29 Report: add software uart signal chain
